gsuckz/SAR_ADC_IHP/out/consumos_conversion.txt

i_rms = 8.028214e-03
potencia_rms = 1.445079e-02
energia_conv = 2.032335e-10
energia_bit = 1.693613e-11
