gsuckz/SAR_ADC_IHP/tex/svg-inkscape/DT_comparator_tb_svg-raw.pdf

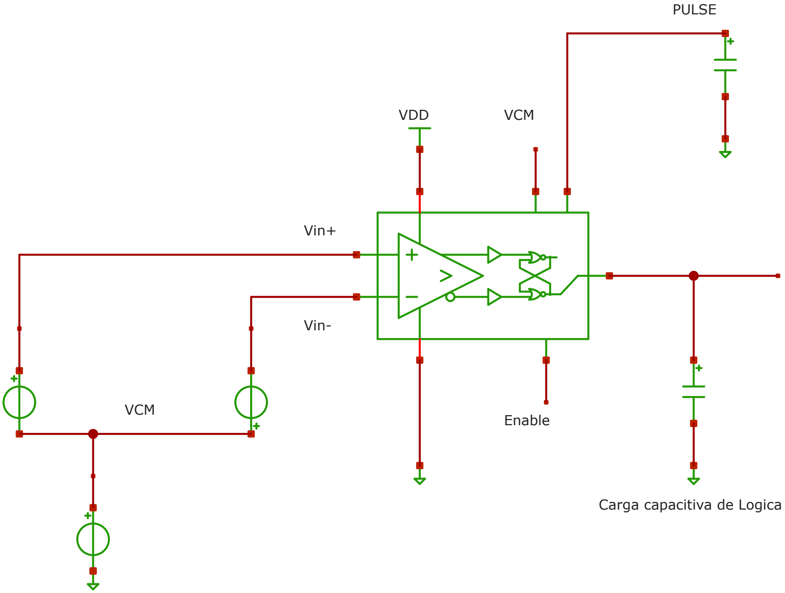
[picture p53: figure]
Carga capacitiva de Logica; VDD; Vin+; Vin-; PULSE; VCM; Enable
