gsuckz/SAR_ADC_IHP/tex/svg-inkscape/nol_diagrama_svg-raw.pdf

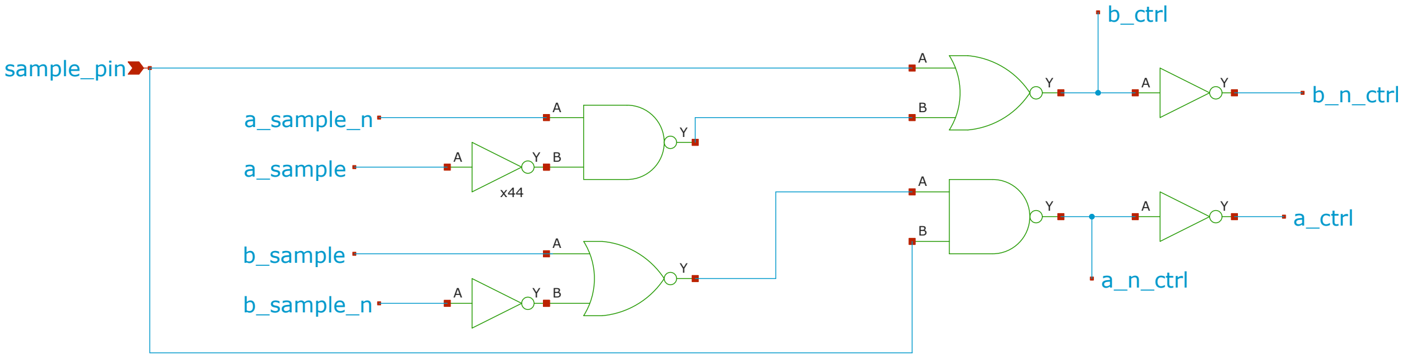
[picture p54: figure]
sample_pin; b_n_ctrl; b_ctrl; a_ctrl; a_n_ctrl; a_sample_n; a_sample; b_sample_n; b_sample
