gsuckz/SAR_ADC_IHP/tex/svg-inkscape/tb_sar_adc_svg-raw.pdf

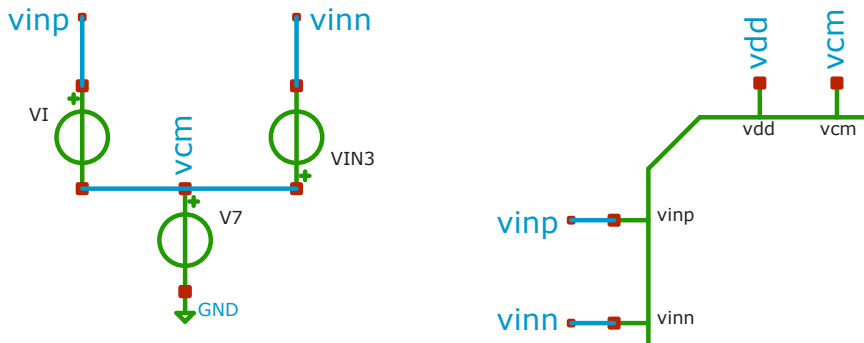
[picture p55: figure]
vinp; vinn; vdd; vcm VI; GND; VIN3; vcm

d0

vdd

# d1d2d3d4d5d6d7d8d9d10 d11

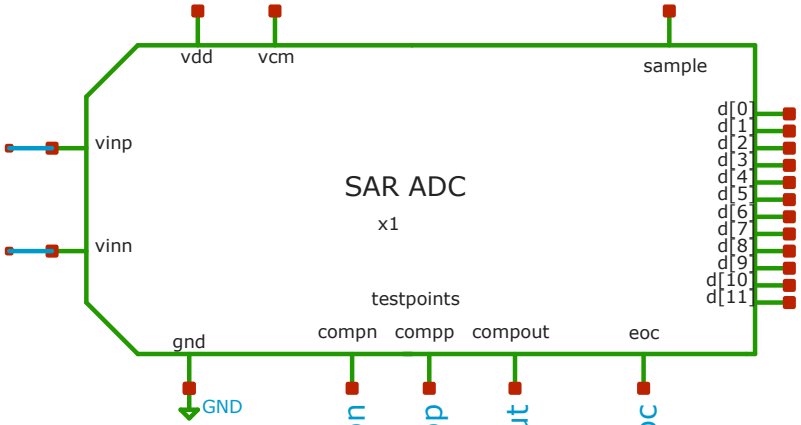
[picture p56: figure]
SAR ADC; sample; gnd; compn compp compout; testpoints; eoc; GND

## compn

## compp

## compout

eoc

GND

V2

## sample

GND

## sample

V3
