gsuckz/SAR_ADC_IHP/html/img/comparadorFullLayoutt.pdf

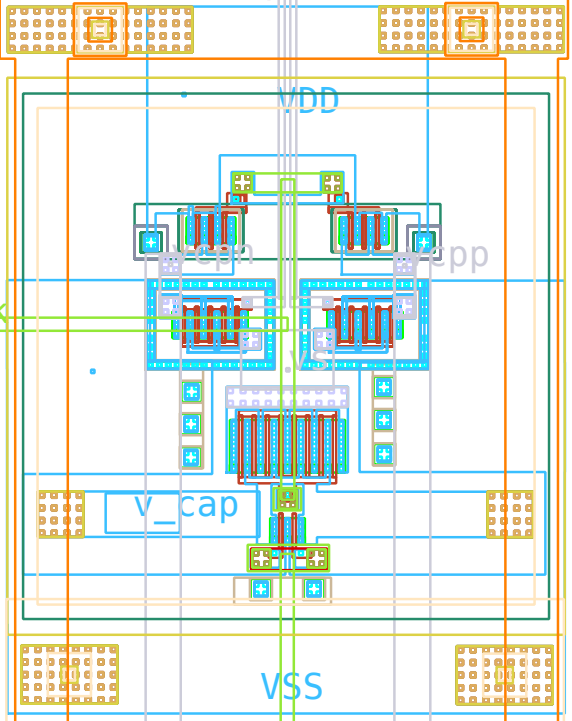
[picture p57: figure]
VSS; v_cap; VDD; vcpn; vcpp

sub! | sub!sub! | sub!
vinp | vinn
voutp | voutn

di_clk_n

di_clk
