gsuckz/SAR_ADC_IHP/tex/svg-inkscape/dynamic_biasing_comparator_export_svg-raw.pdf

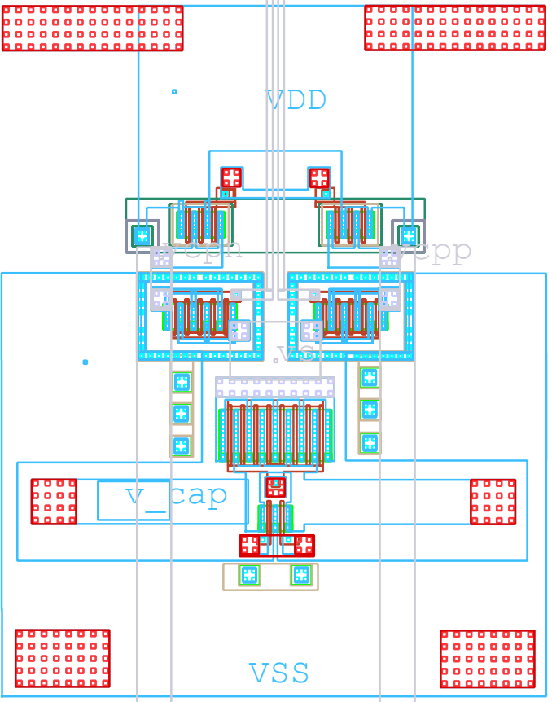
[picture p58: figure]
VSS; v_cap; VDD; vcpn; vcpp

sub! | sub!sub! | sub!

vinp vinn

voutp | voutn
