gsuckz/SAR_ADC_IHP/tex/svg-inkscape/lo_comp_preamp_scap_svg-raw.pdf

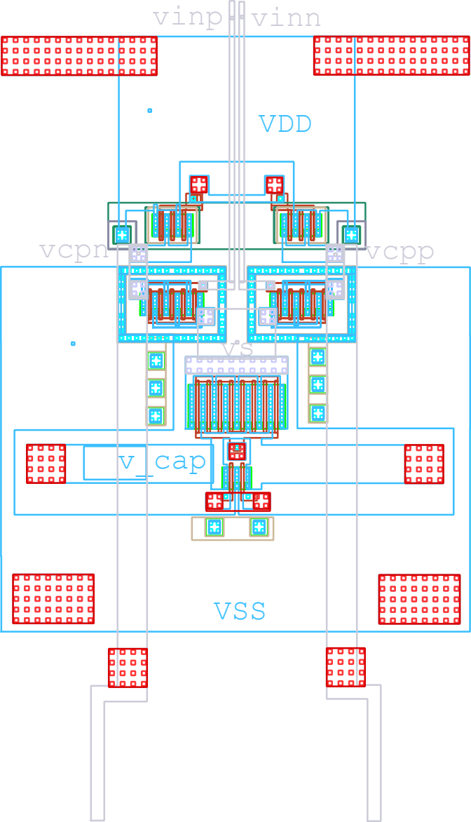
[picture p59: figure]
VSS; v_cap; VDD; vinp vinn; vcpn; vcpp
