gsuckz/SAR_ADC_IHP/tex/svg-inkscape/bit_cell_diagrama_svg-raw.pdf

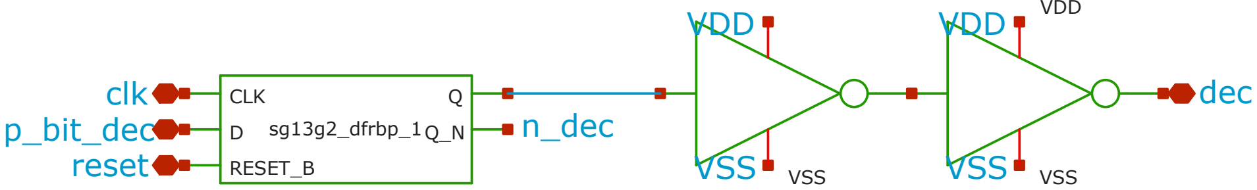
[picture p60: figure]
sg13g2_dfrbp_1; CLK; RESET_B; p_bit_dec; n_dec; clk; reset; dec; VSS; VDD
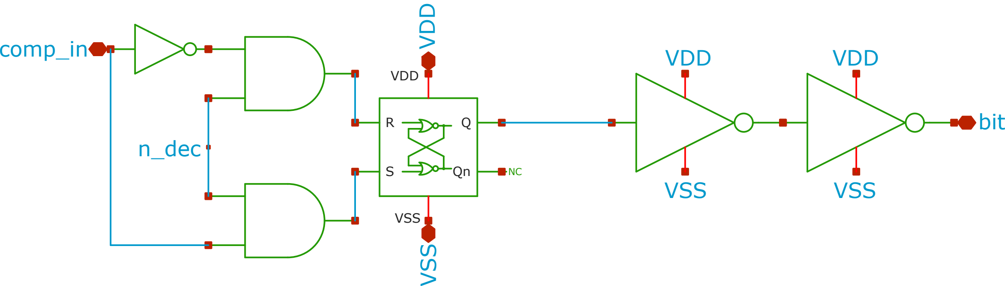
[picture p61: figure]
VDD; VSS; n_dec; comp_in; VDD VSS; bit
