gsuckz/SAR_ADC_IHP/tex/svg-inkscape/logica_parte_svg-raw.pdf

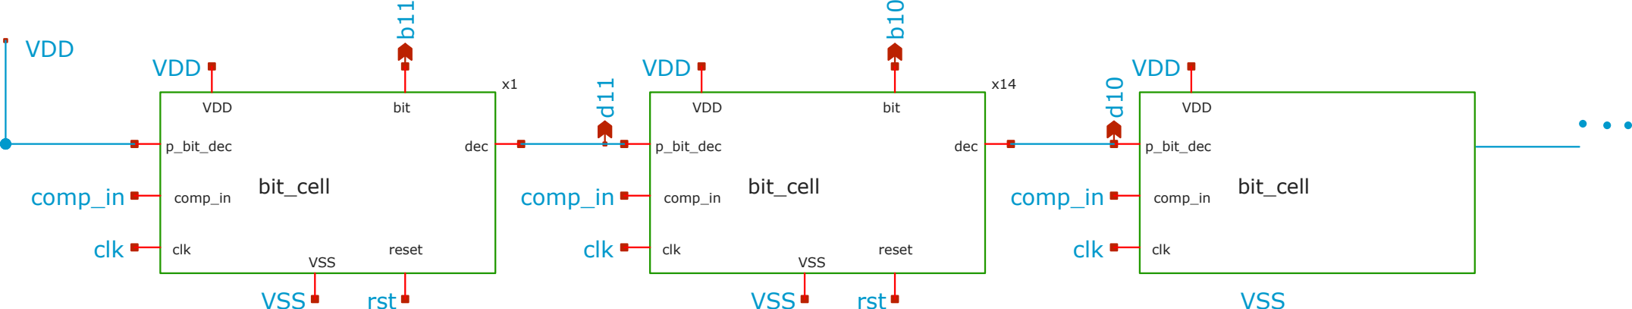
[picture p62: figure]
clk; rst; comp_in; VDD; bit_cell; p_bit_dec; reset; bit; VSS; dec
