gsuckz/SAR_ADC_IHP/tex/svg-inkscape/pgen_schimtt_trigger_diagrama_svg-raw.pdf

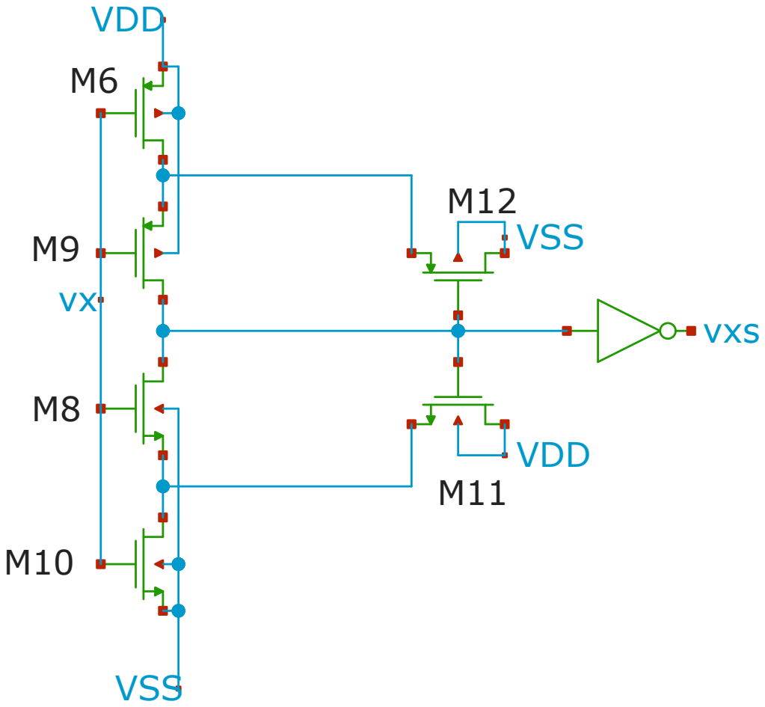
[picture p63: figure]
VDD; VSS; vxs
