gsuckz/SAR_ADC_IHP/tex/svg-inkscape/tg_diagrama_dummies_svg-raw.pdf

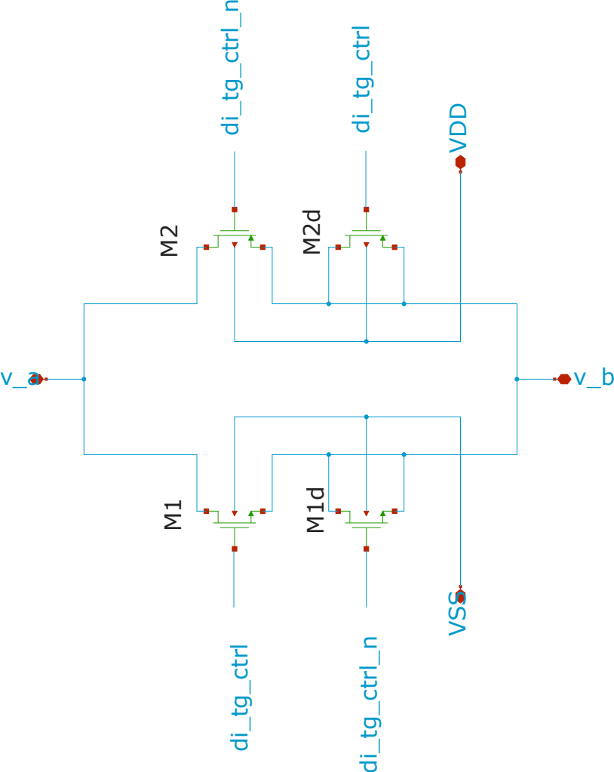
[picture p64: figure]
M²d M¹d; di_tg_ctrl di_tg_ctrl_n; VDD VSS di_tg_ctrl di_tg_ctrl_n
