gsuckz/SAR_ADC_IHP/html/assets/images/cdac/cdac_3x3_dark.png

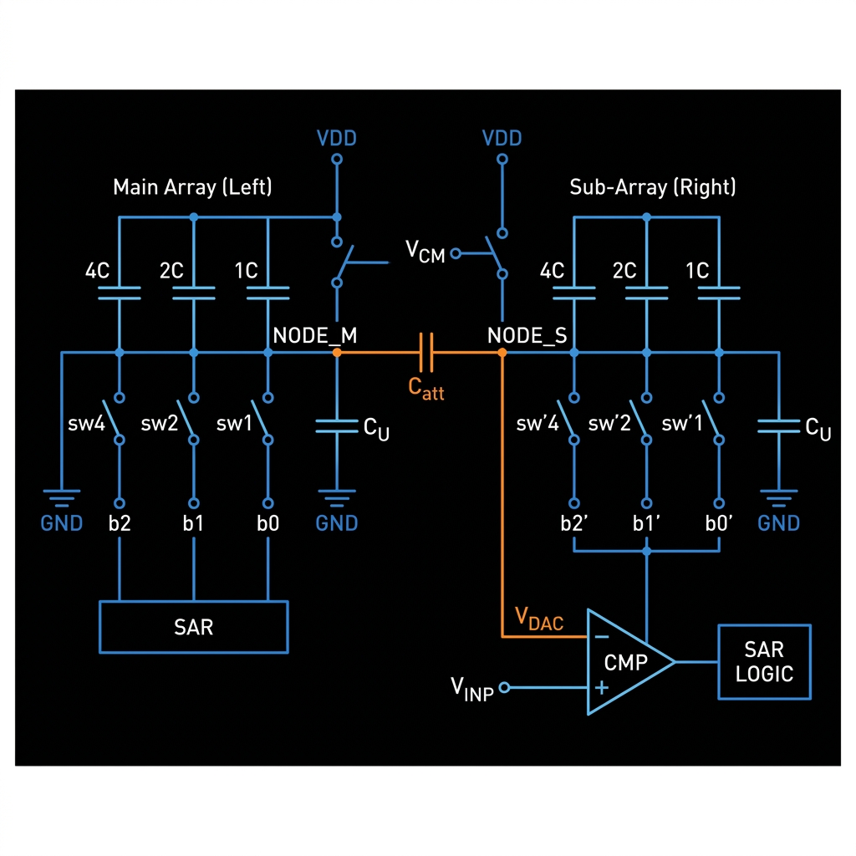
html/assets/images/cdac/cdac_3x3_dark.png
