gsuckz/SAR_ADC_IHP/html/assets/images/comparator/DT_comparator_dark.png

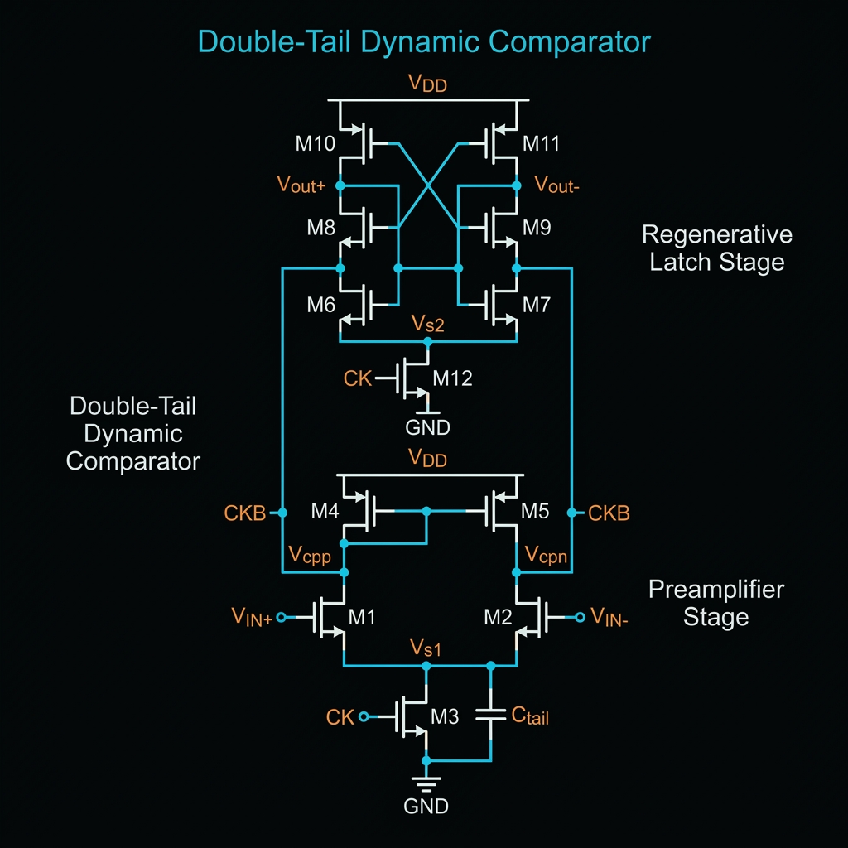
html/assets/images/comparator/DT_comparator_dark.png
