gsuckz/SAR_ADC_IHP/html/assets/images/logic_timing/pgen_diagram_dark.png

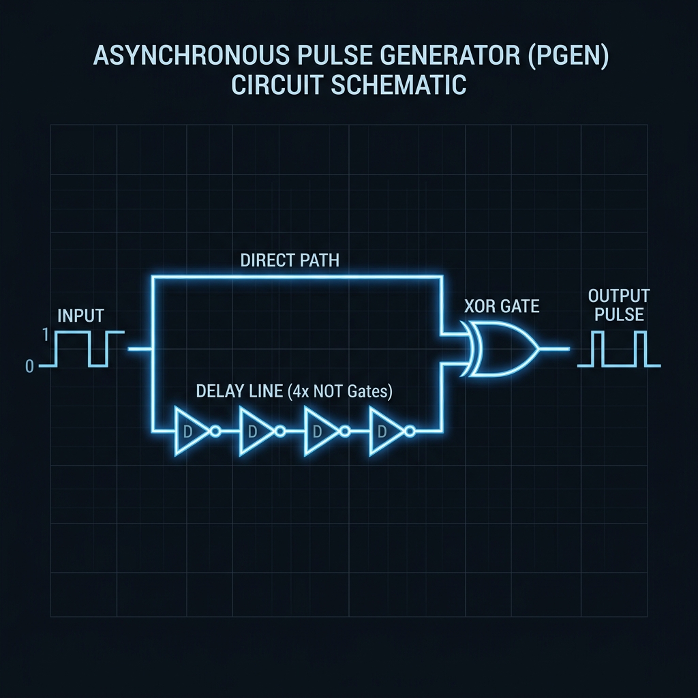
html/assets/images/logic_timing/pgen_diagram_dark.png
