gsuckz/SAR_ADC_IHP/html/assets/images/misc/logica_parte_dark.png

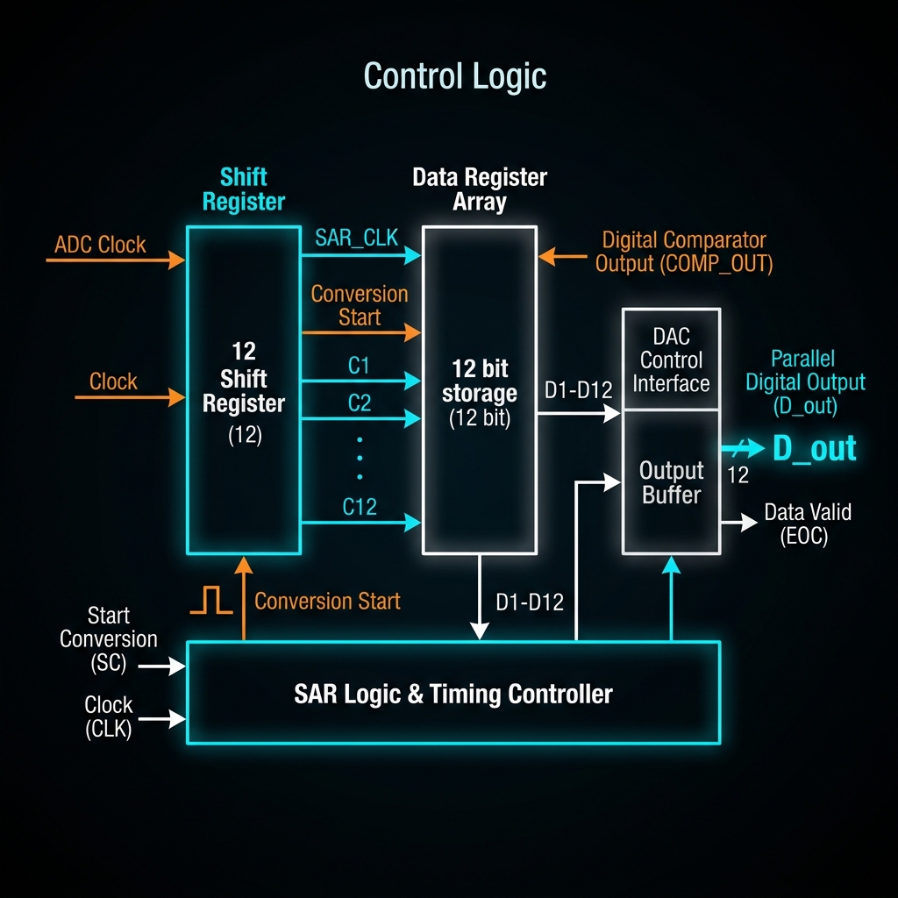
html/assets/images/misc/logica_parte_dark.png
