gsuckz/SAR_ADC_IHP/html/img2/cdac_cell_sch.png

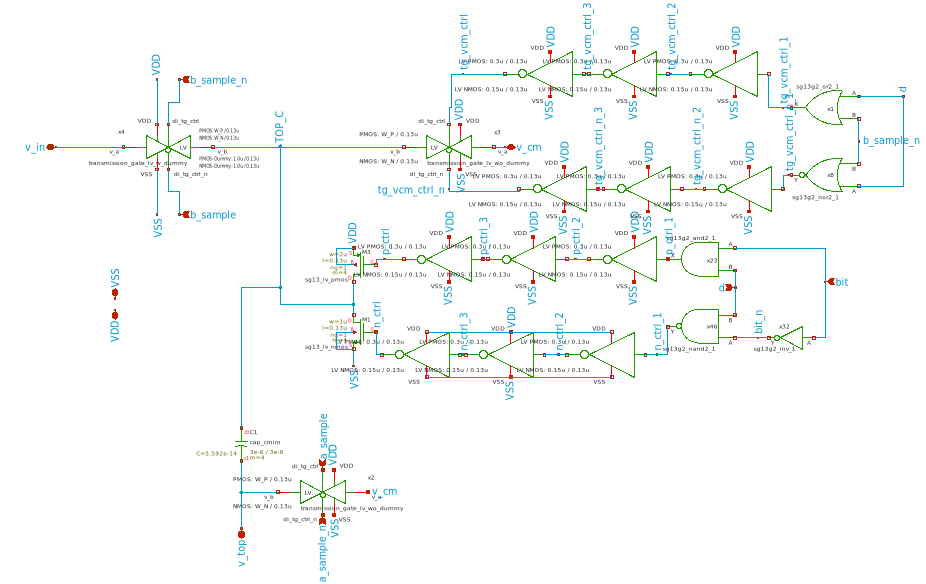
html/img2/cdac_cell_sch.png
