gsuckz/SAR_ADC_IHP/html/img2/Conversion IMCS ejemplo.png

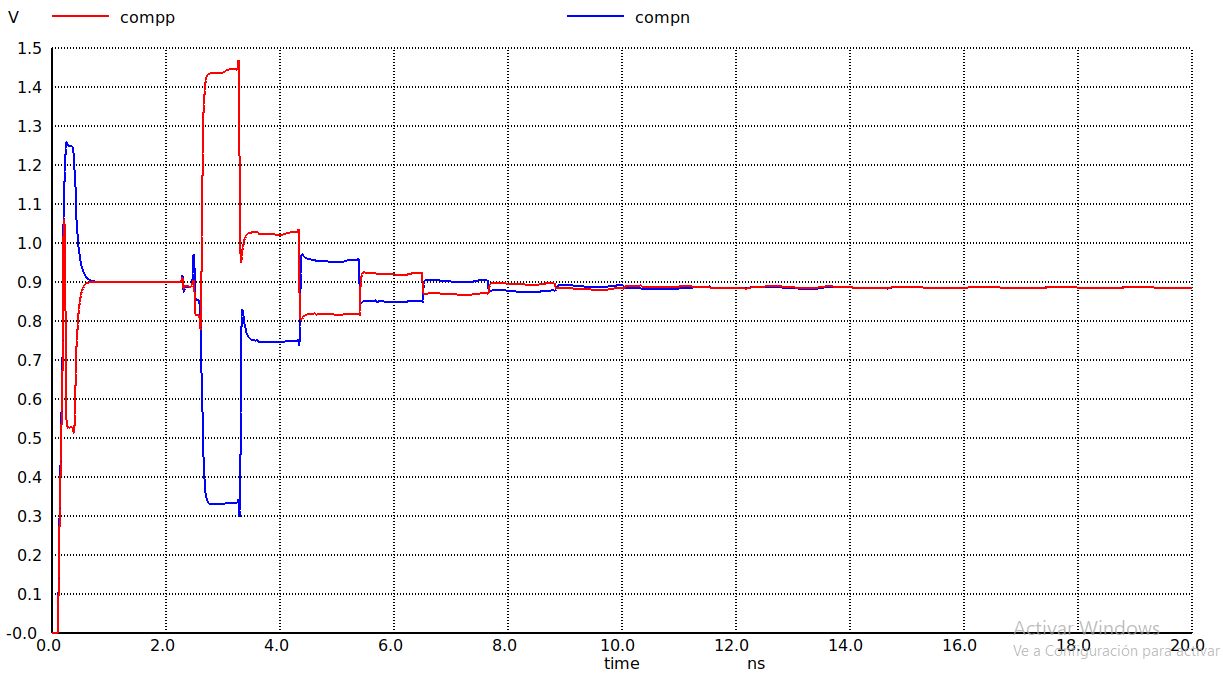
html/img2/Conversion IMCS ejemplo.png
