gsuckz/SAR_ADC_IHP/html/img2/explicacion_grounding_y_bridge_cap.png

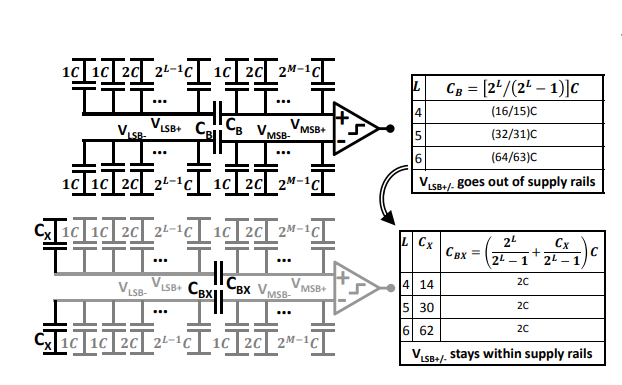
html/img2/explicacion_grounding_y_bridge_cap.png
