gsuckz/SAR_ADC_IHP/html/img2/formas_de_onda_logica_SAR.png

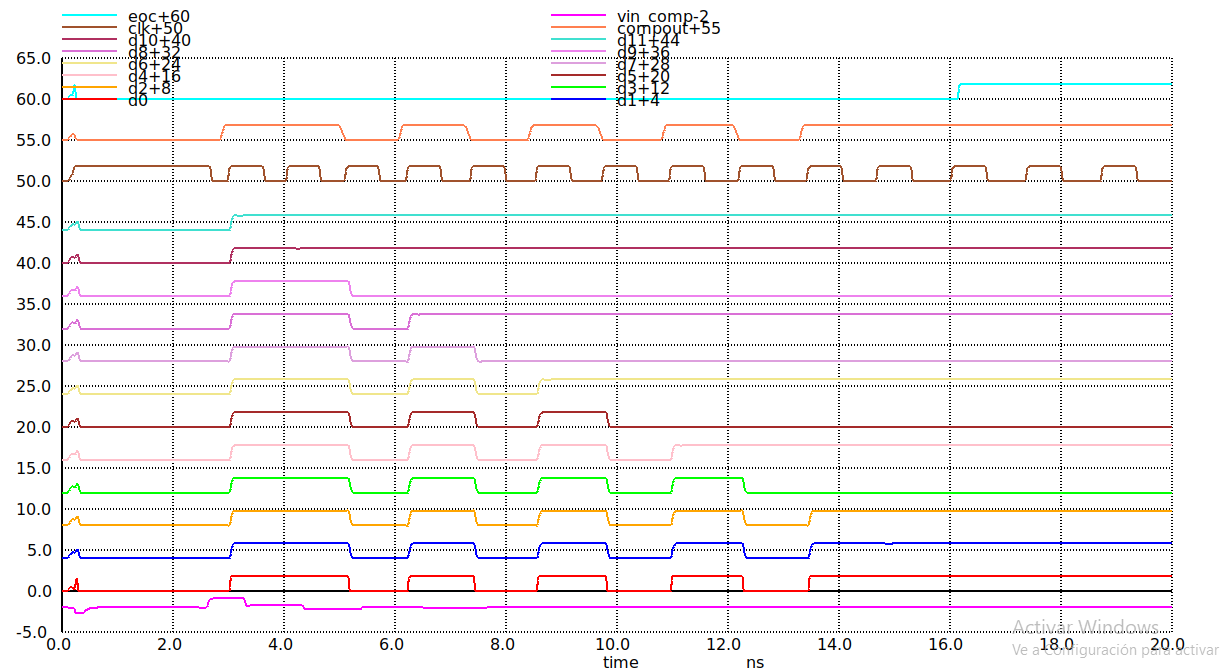
html/img2/formas_de_onda_logica_SAR.png
