gsuckz/SAR_ADC_IHP/html/img2/kickback_comparador_explicacion.png

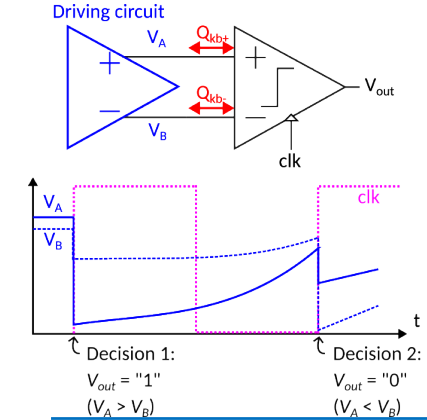
html/img2/kickback_comparador_explicacion.png
