gsuckz/SAR_ADC_IHP/html/img2/non_overlap_con_buffer_sch.png

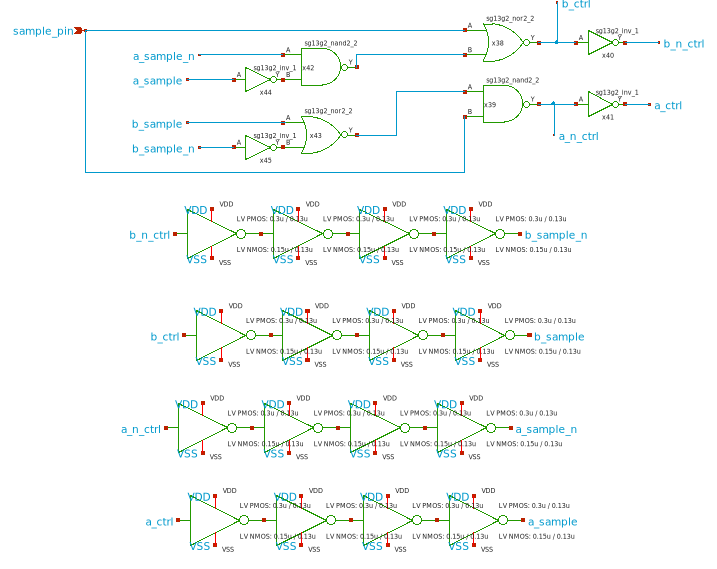
html/img2/non_overlap_con_buffer_sch.png
