gsuckz/SAR_ADC_IHP/html/img/CapturaDeUnaVentanaDeKlayout.png

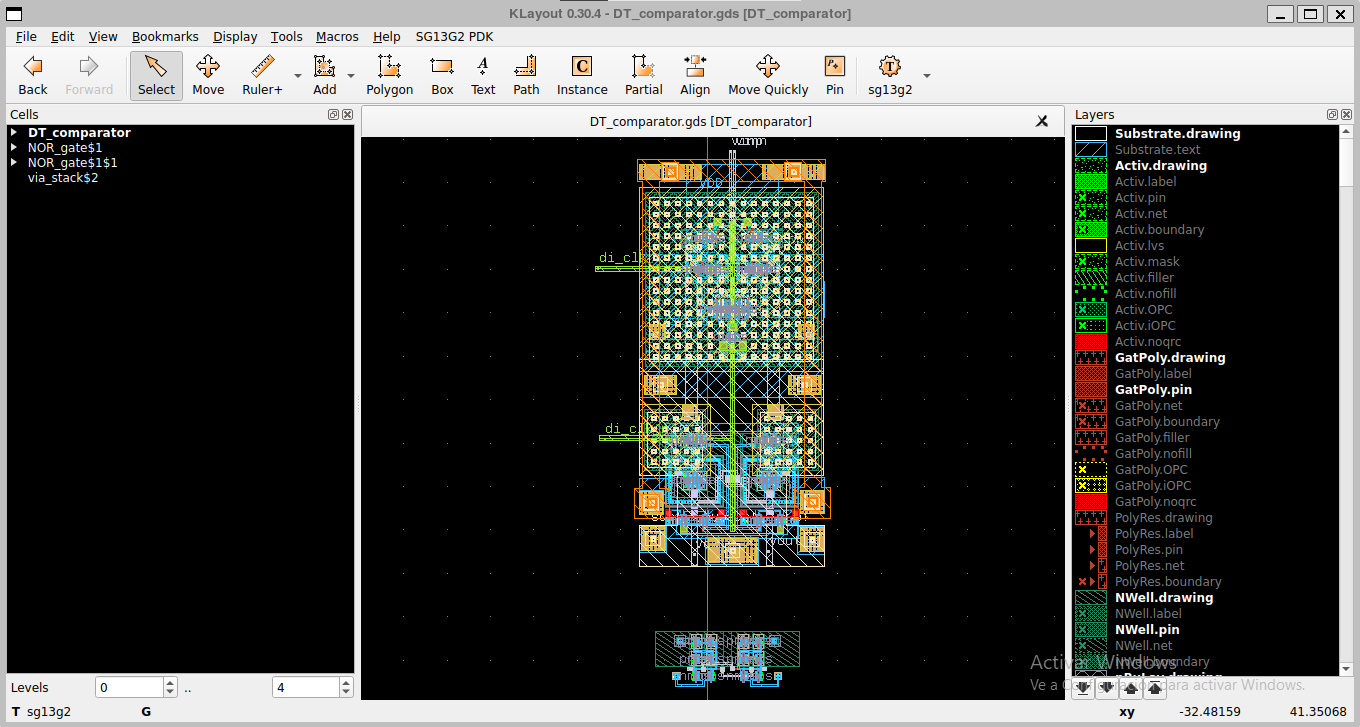
html/img/CapturaDeUnaVentanaDeKlayout.png
