gsuckz/SAR_ADC_IHP/html/img/CapturaDeUnaVentanaDeNgspice.png

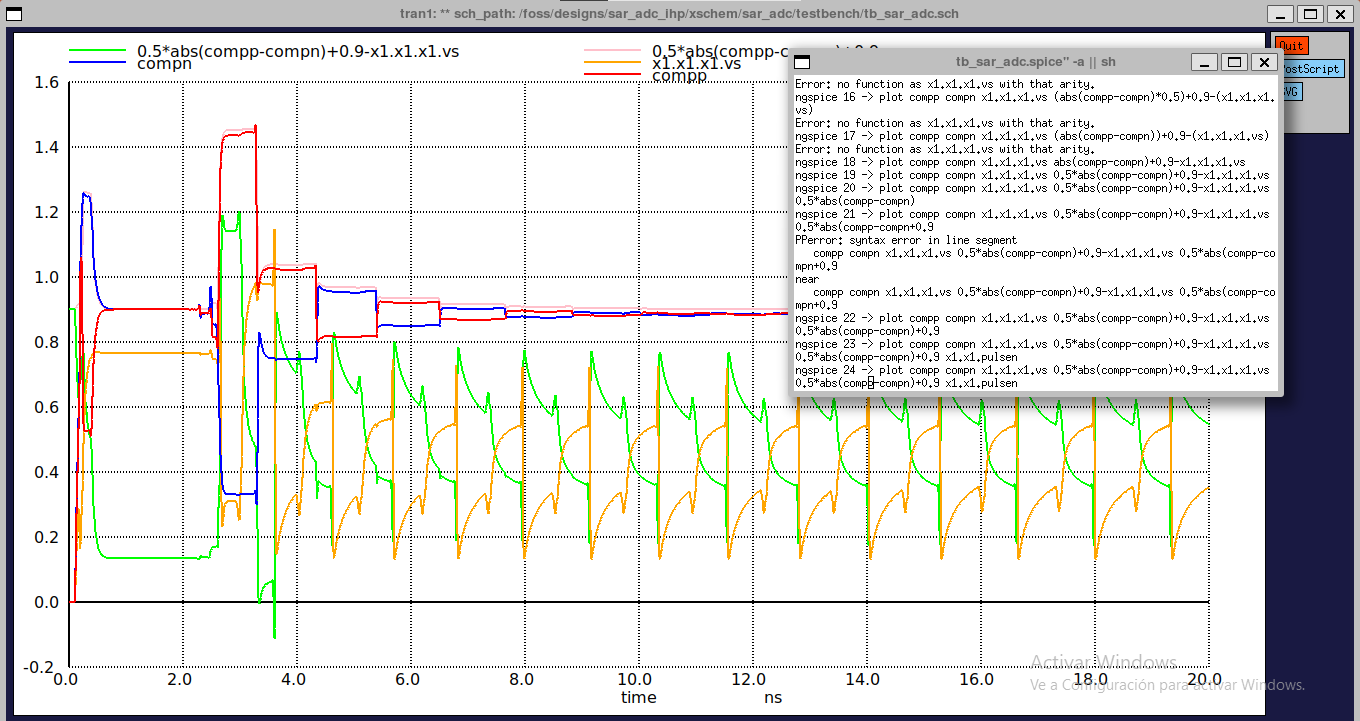
html/img/CapturaDeUnaVentanaDeNgspice.png
