gsuckz/SAR_ADC_IHP/html/img/CapturaDeUnaVentanaDeXschem.png

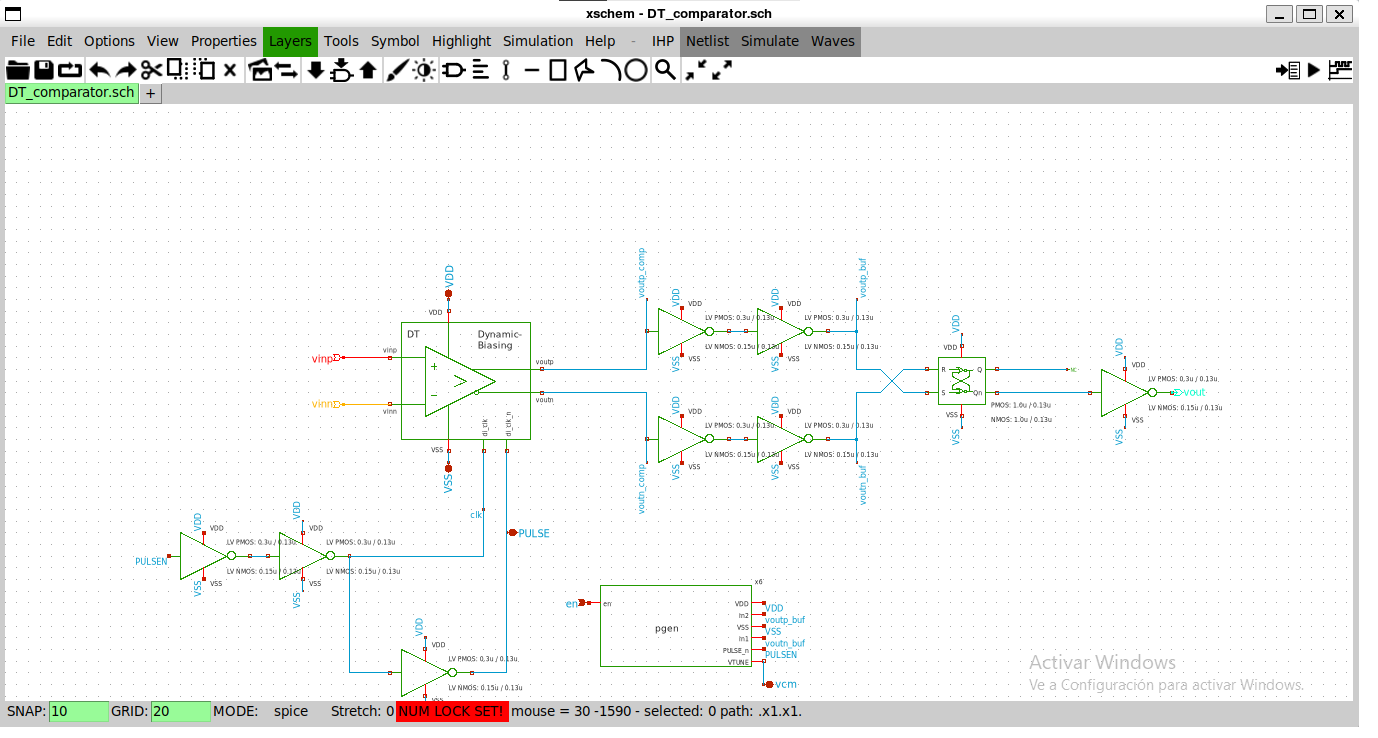
html/img/CapturaDeUnaVentanaDeXschem.png
