gsuckz/SAR_ADC_IHP/html/img/DiagramaPulseGenExplicado.png

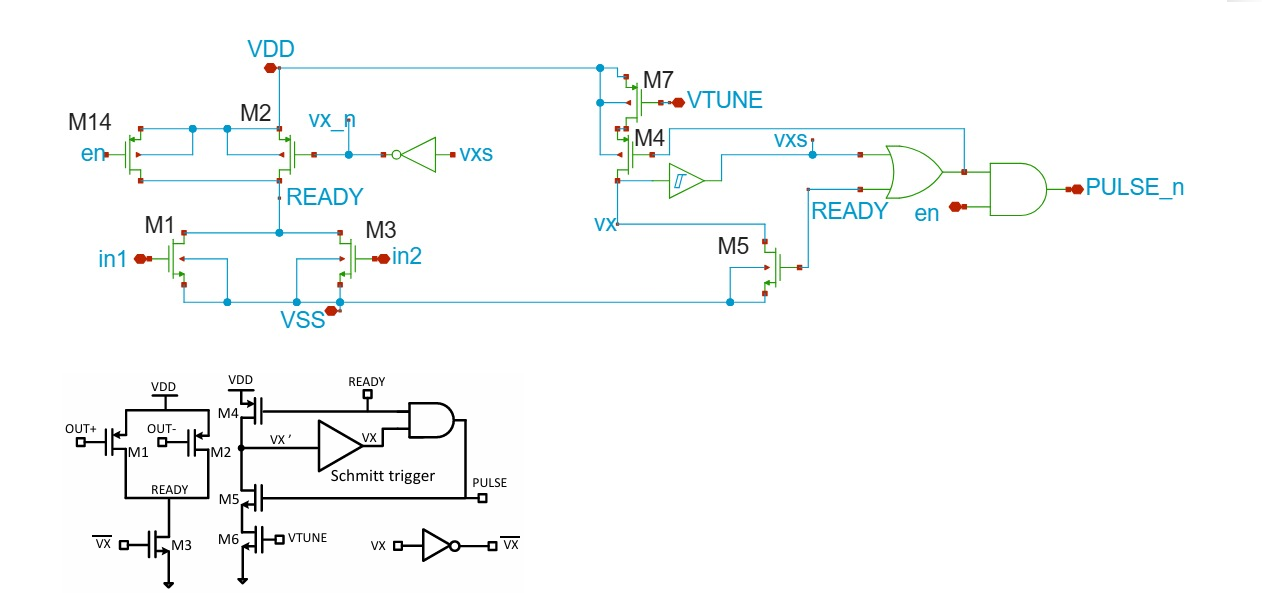
html/img/DiagramaPulseGenExplicado.png
