gsuckz/SAR_ADC_IHP/html/img/ExplicacionFasesDelComparadorCompletoEnDiagrama.png

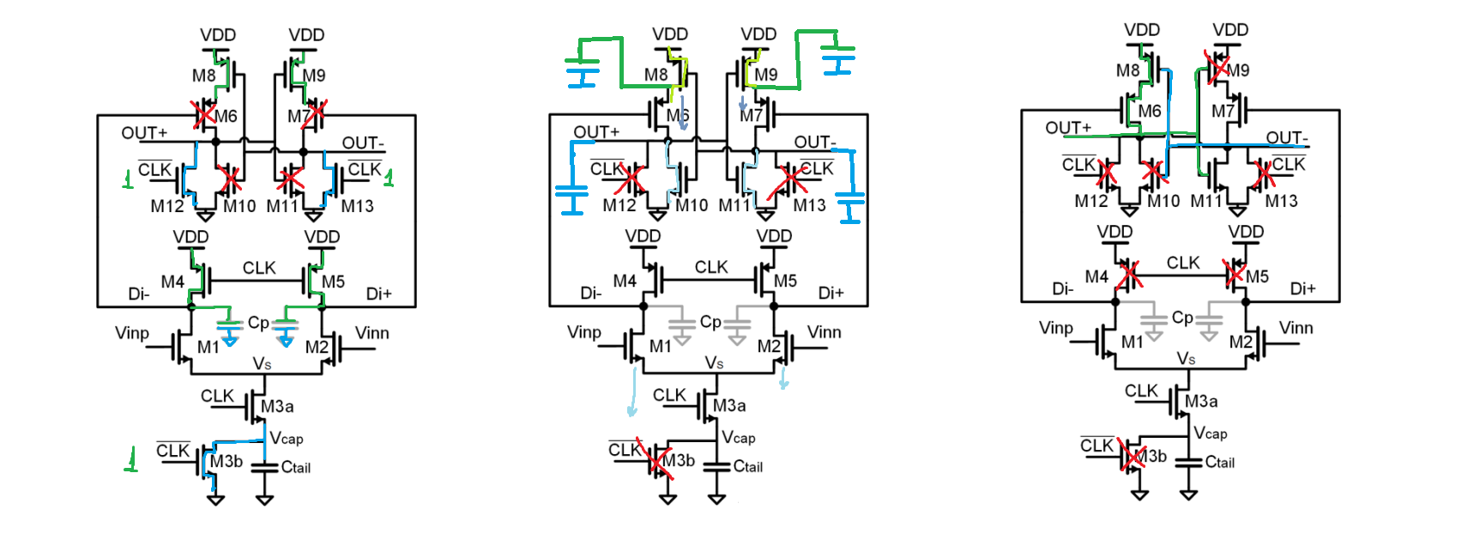
html/img/ExplicacionFasesDelComparadorCompletoEnDiagrama.png
