gsuckz/SAR_ADC_IHP/html/img/IMCS_Explicacion.png

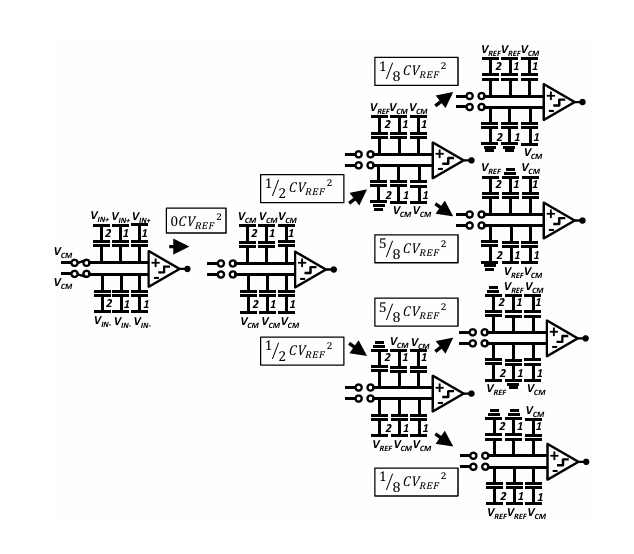
html/img/IMCS_Explicacion.png
