gsuckz/SAR_ADC_IHP/html/img/InstanciacionDeUnaPCellEnKLayout.png

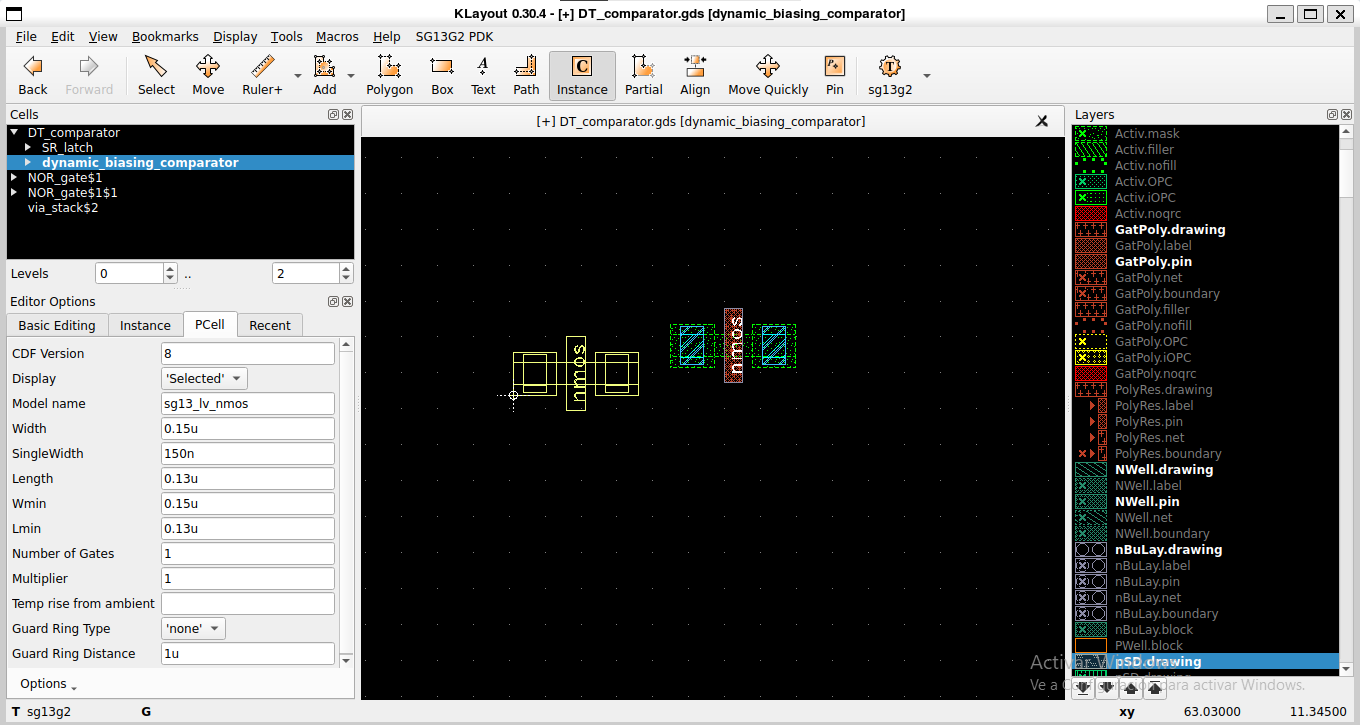
html/img/InstanciacionDeUnaPCellEnKLayout.png
