gsuckz/SAR_ADC_IHP/html/img/SeñalesComapradorVin219mV.png

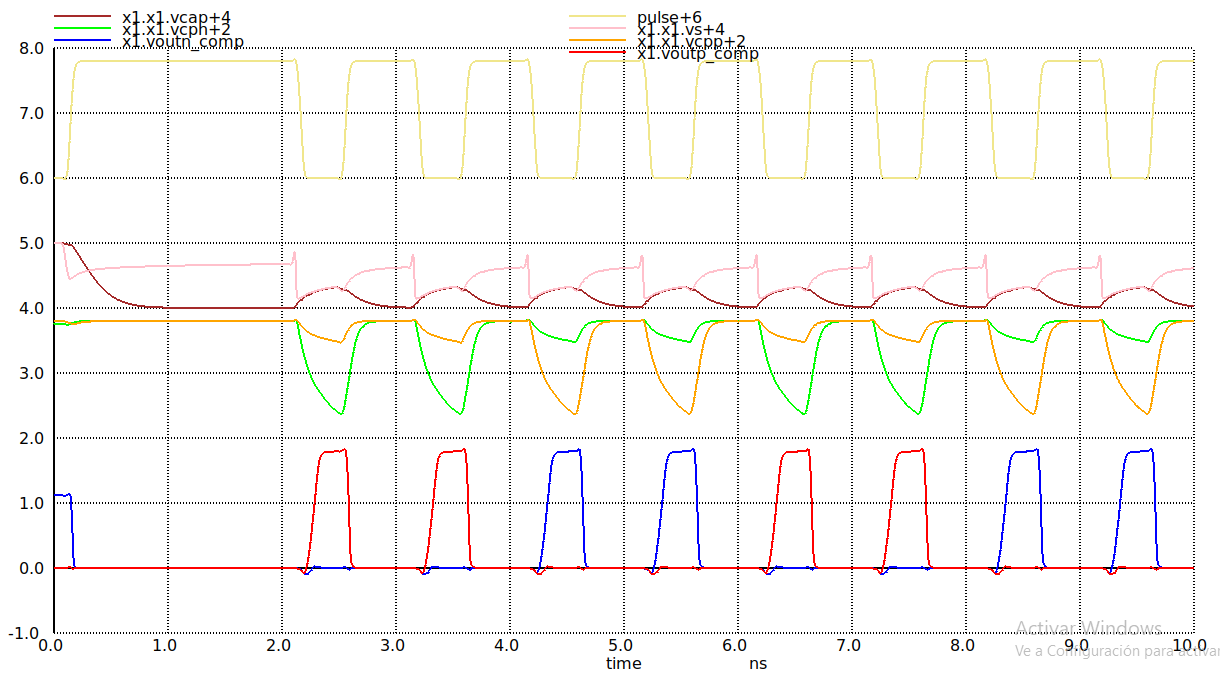
html/img/SeñalesComapradorVin219mV.png
