gsuckz/SAR_ADC_IHP/html/img/SeñalesComapradorVin219uV.png

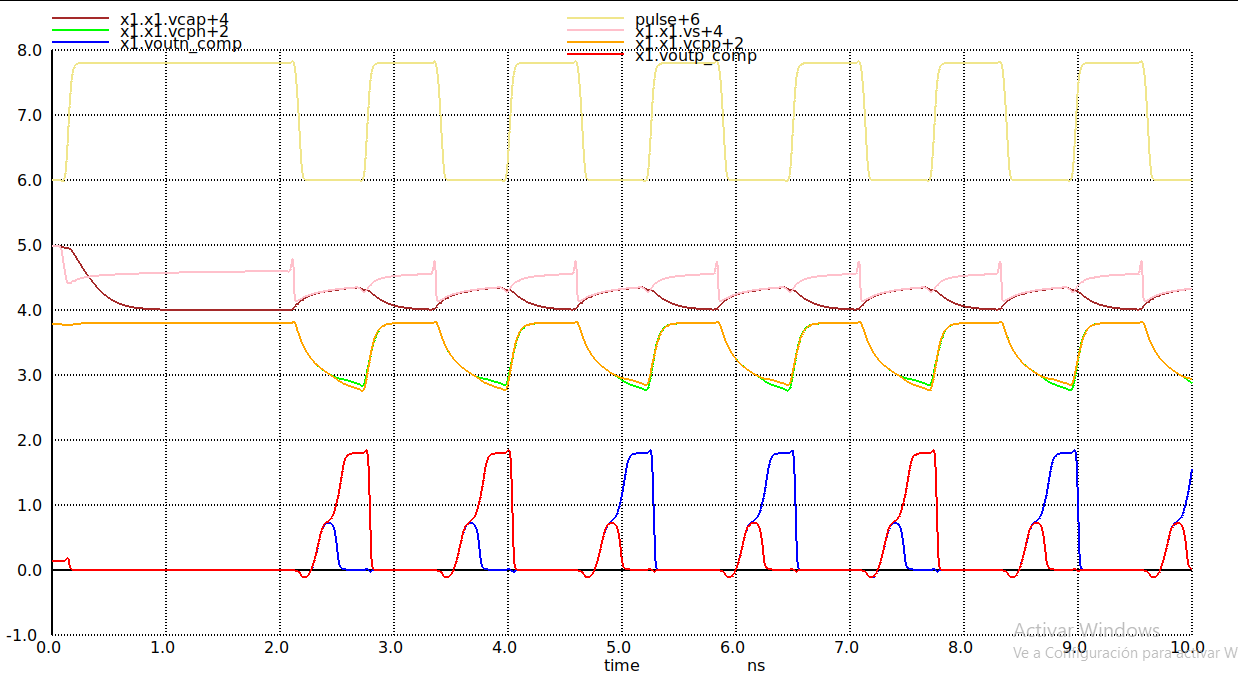
html/img/SeñalesComapradorVin219uV.png
