gsuckz/SAR_ADC_IHP/html/img/StackDelProcesoIHPsg13g2Layout.png

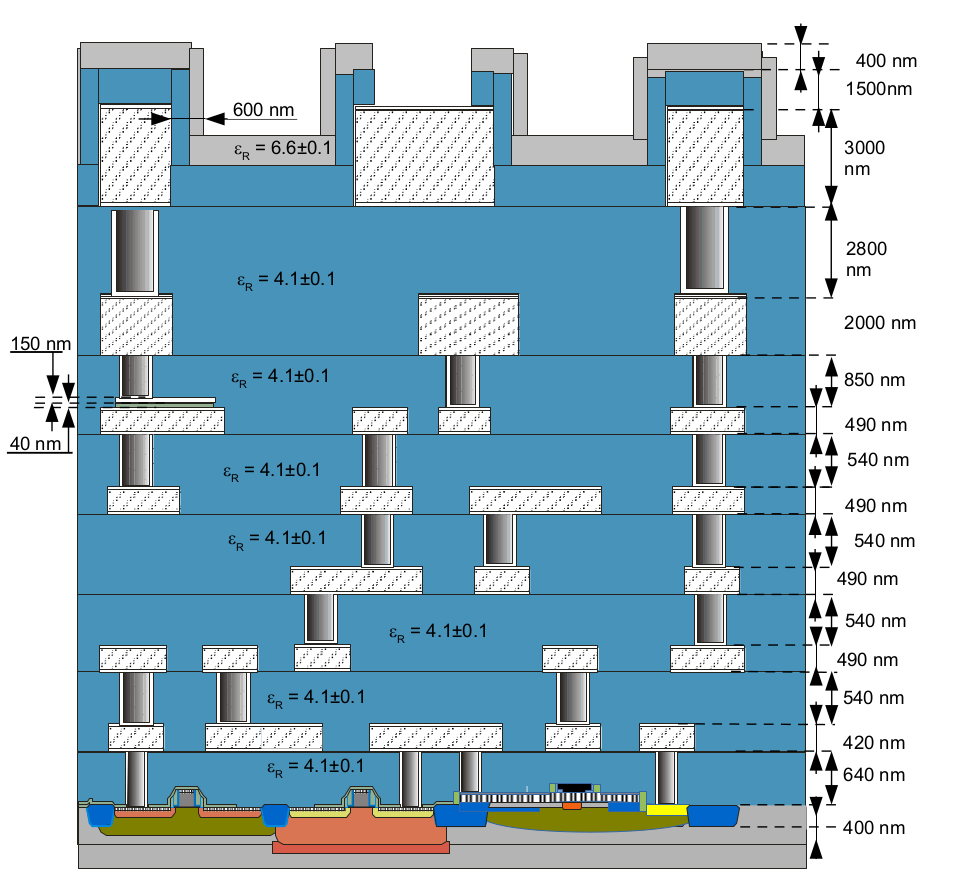
html/img/StackDelProcesoIHPsg13g2Layout.png
