gsuckz/SAR_ADC_IHP/html/img/Switch de muestreo con transistores dummy.png

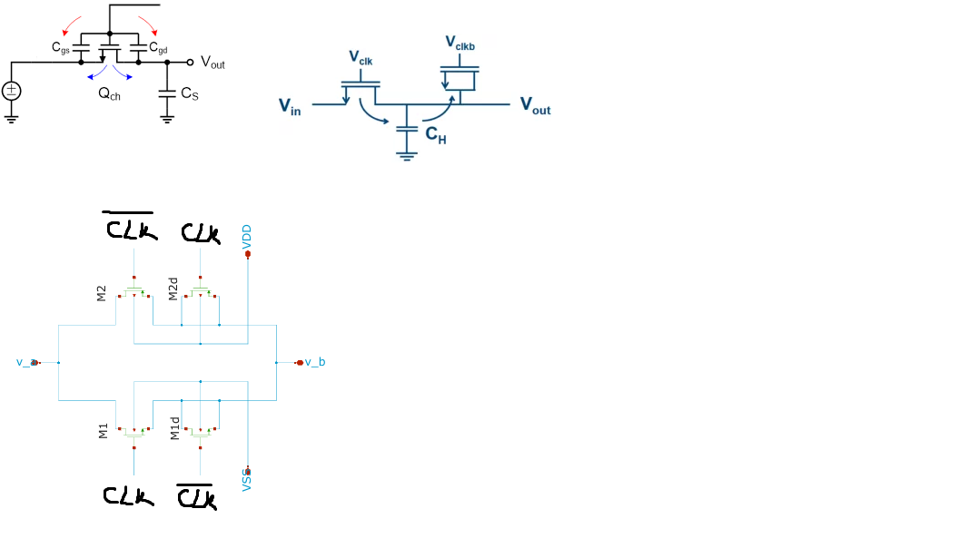
html/img/Switch de muestreo con transistores dummy.png
