gsuckz/SAR_ADC_IHP/xschem/sar.png

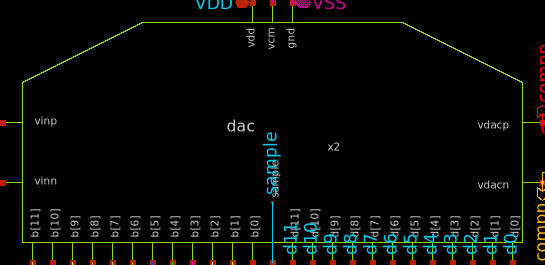
xschem/sar.png
