gsuckz/SAR_ADC_IHP/tex/svg-inkscape/tb_top_tran_step_svg-raw.pdf

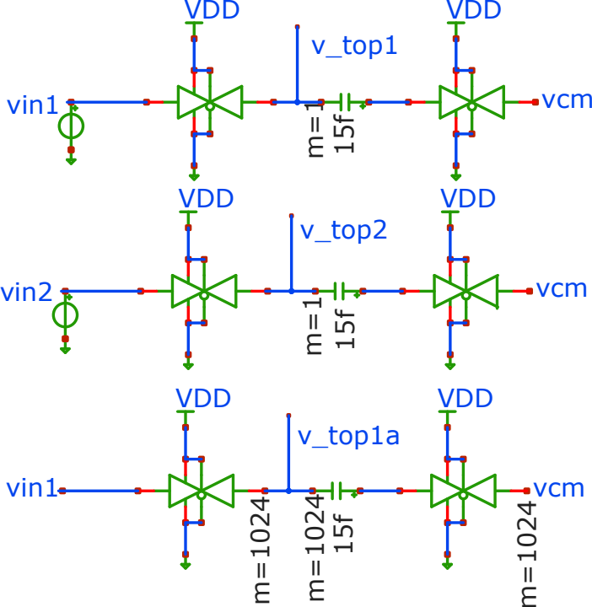
[picture p88: figure]
vin1; VDD; vcm; v_top1; vin2; v_top2; v_top1a m=¹ 15f m=¹ 15f 15f
