gsuckz/SAR_ADC_IHP/tex/svg-inkscape/dynamic_biasing_comparator_svg-raw.pdf

## B VDD

# Latch

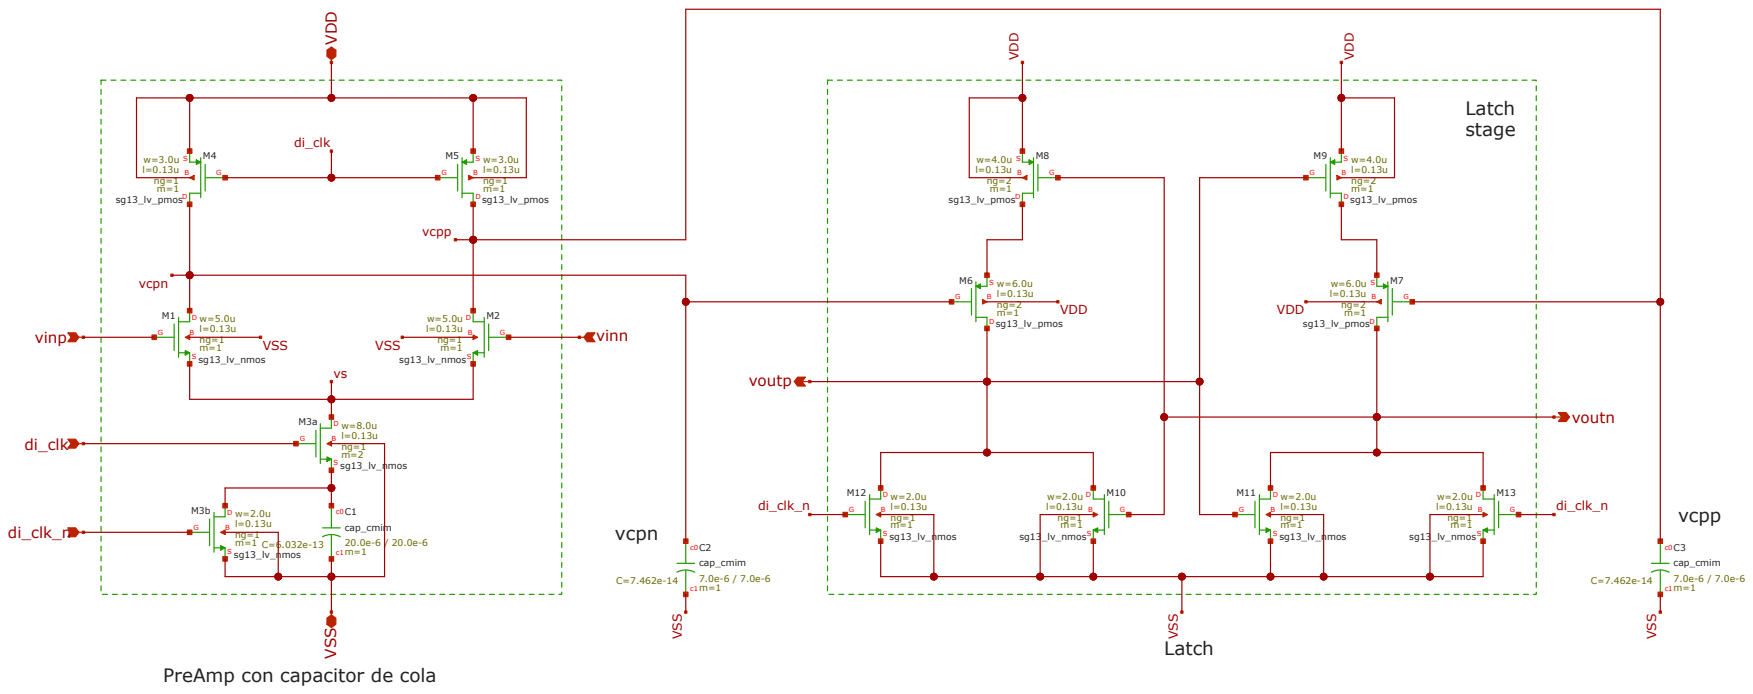
[picture p89: page 1]
VDD; voutp; voutn; di_clk_n; VSS; vinp; vinn; di_clk; sg13_lv_nmos; sg13_lv_pmos; vcpp; vcpn; cap_cmim; stage; Latch

PreAmp con capacitor de cola
