gsuckz/SAR_ADC_IHP/tex/svg-inkscape/conversion_ejemplo_1_svg-raw.pdf

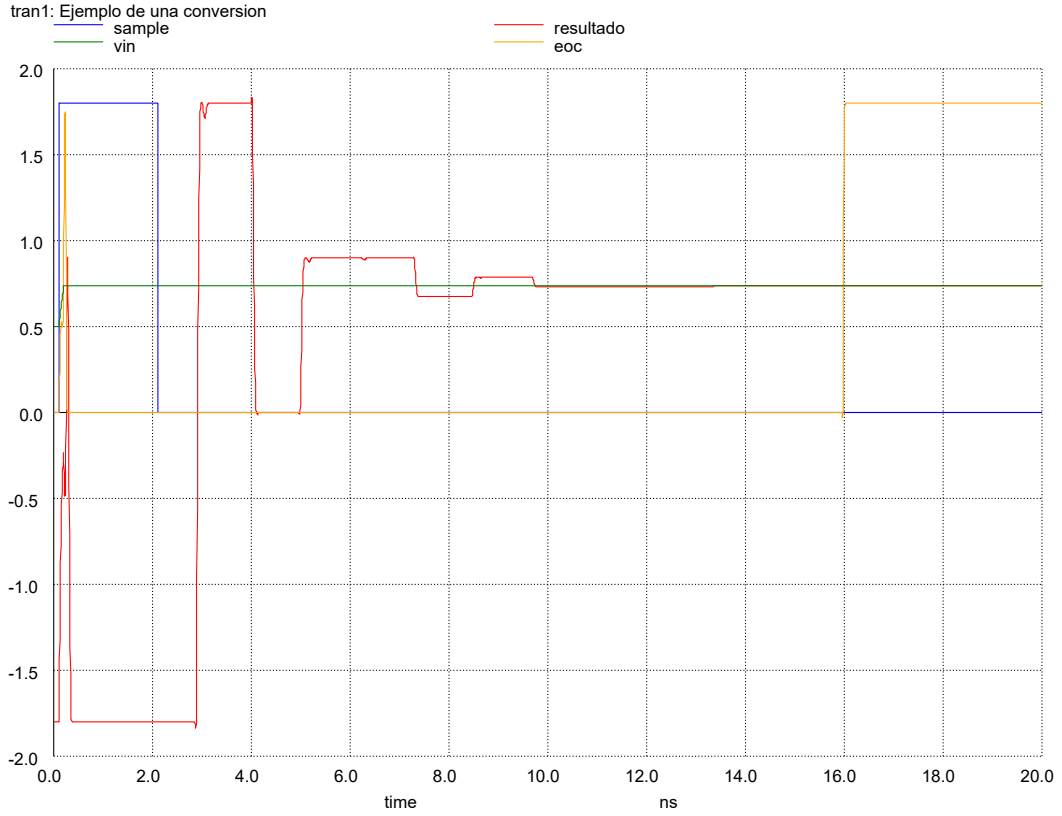
[picture p90: page 1]
time; sample; resultado; vin; eoc

tran1: Ejemplo de una conversion
