gsuckz/SAR_ADC_IHP/tex/svg-inkscape/nol_formas_de_onda_editado_svg-raw.pdf

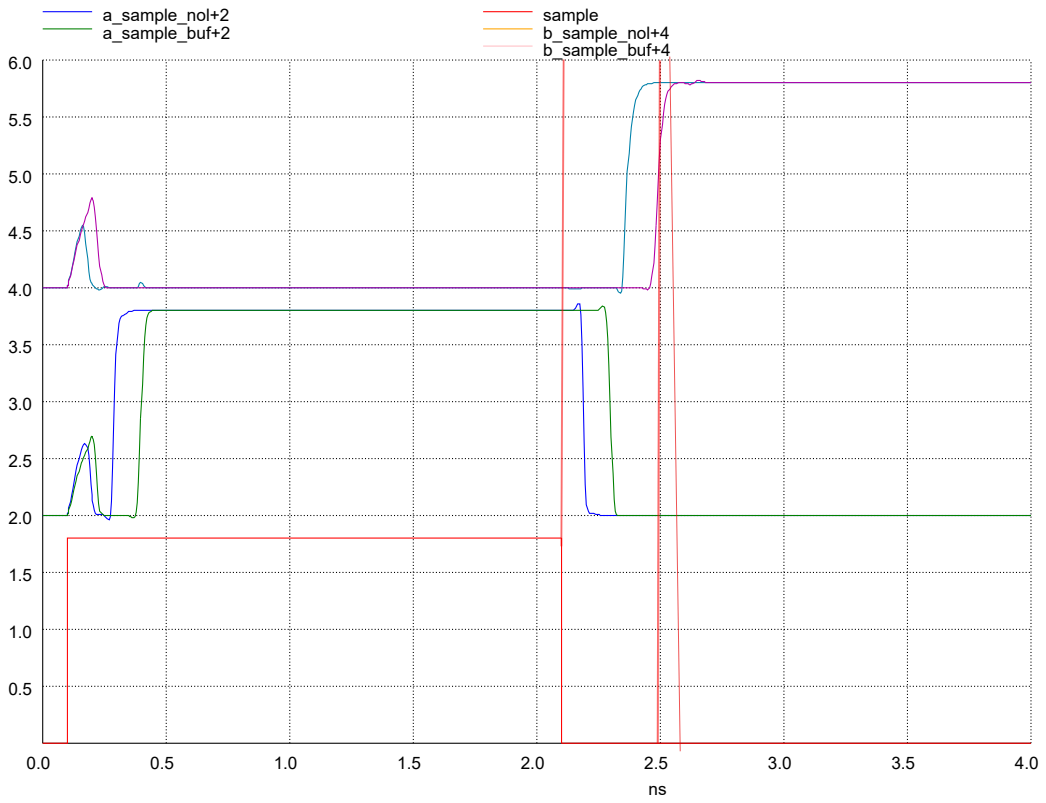
[picture p91: page 1]
a_sample_nol+2; sample; a_sample_buf+2; b_sample_nol+4; b_sample_buf+4
