gsuckz/SAR_ADC_IHP/tex/svg-inkscape/nol_salidas_editado_svg-raw.pdf

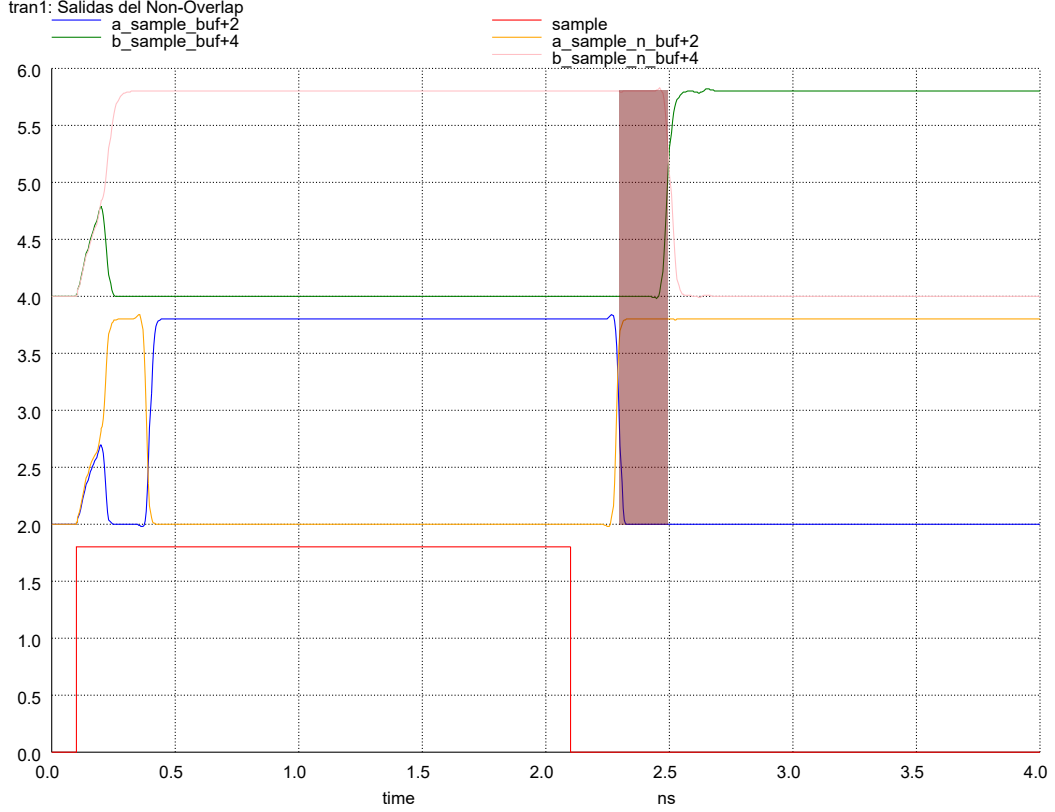
[picture p92: page 1]
time; a_sample_buf+2; sample; b_sample_buf+4; a_sample_n_buf+2; b_sample_n_buf+4

tran1: Salidas del Non-Overlap
