gsuckz/SAR_ADC_IHP/tex/svg-inkscape/respuesta_c_svg-raw.pdf

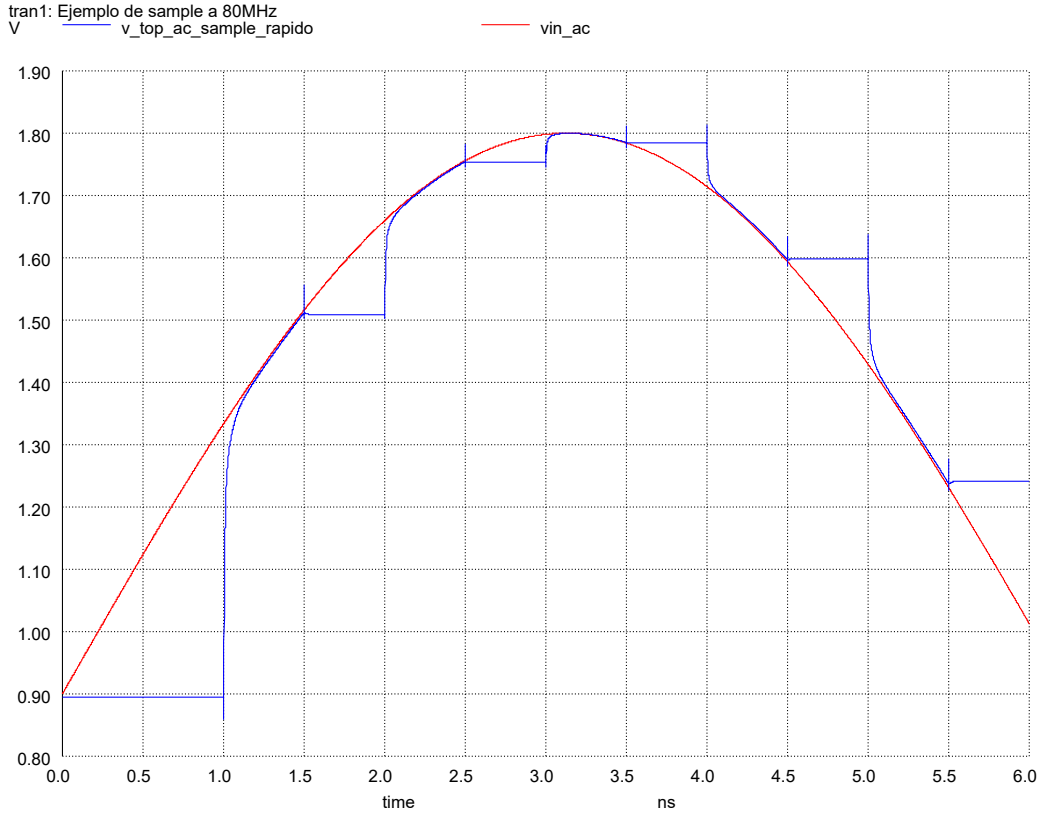
[picture p93: page 1]
time; v_top_ac_sample_rapido; vin_ac

tran1: Ejemplo de sample a 80MHz
