gsuckz/SAR_ADC_IHP/tex/svg-inkscape/rise_topa_svg-raw.pdf

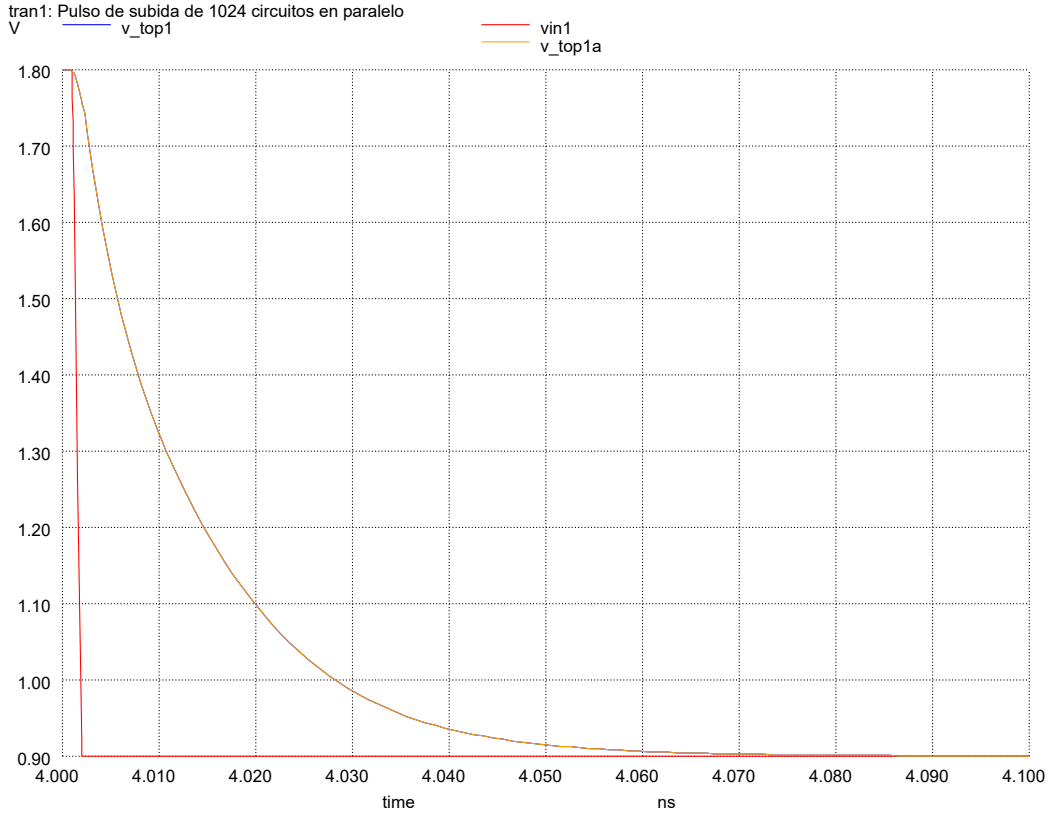
[picture p94: page 1]
time; v_top1; vin1; v_top1a

tran1: Pulso de subida de 1024 circuitos en paralelo
