gsuckz/SAR_ADC_IHP/html/img/pgenlayoutexplicado.pdf

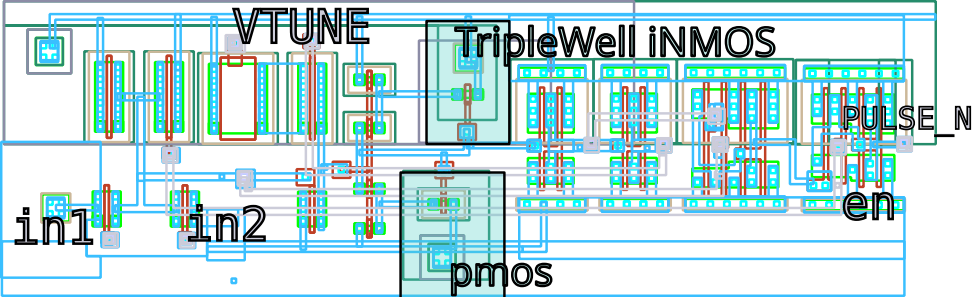
[picture p95: page 1]
VTUNE; PULSE_N; TripleWell iNMOS; pmos
