gsuckz/SAR_ADC_IHP/tex/svg-inkscape/lo_comp_preamp_fl_svg-raw.pdf

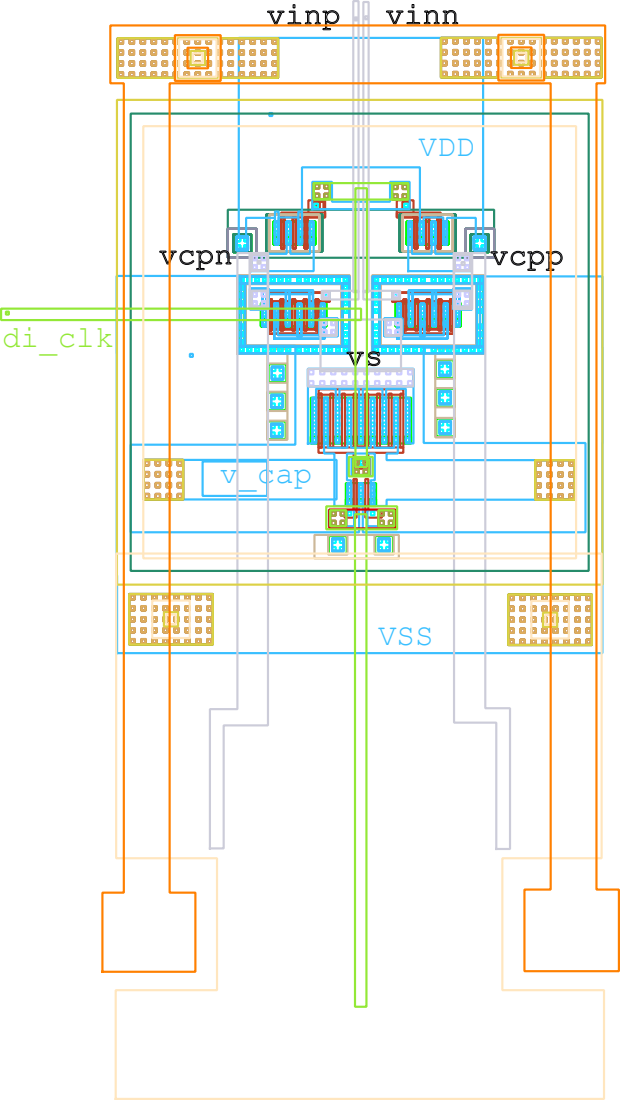
[picture p96: page 1]
VSS; v_cap; VDD; vinp; vinn; vcpn; vcpp; vs di_clk
