gsuckz/SAR_ADC_IHP/tex/svg-inkscape/bindra_preamp_diagrama_svg-raw.pdf

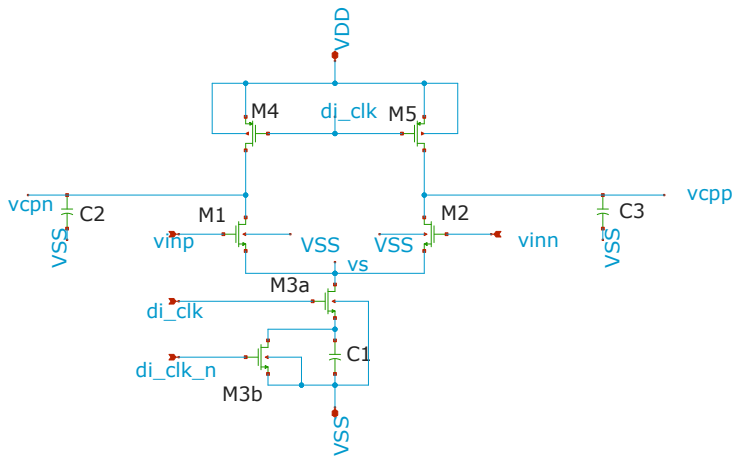
[picture p97: page 1]
VDD; di_clk_n; VSS; vinp; vinn; di_clk; di_clk M5; vcpp vcpn
