gsuckz/SAR_ADC_IHP/tex/svg-inkscape/conversion_comparador_1_svg-raw.pdf

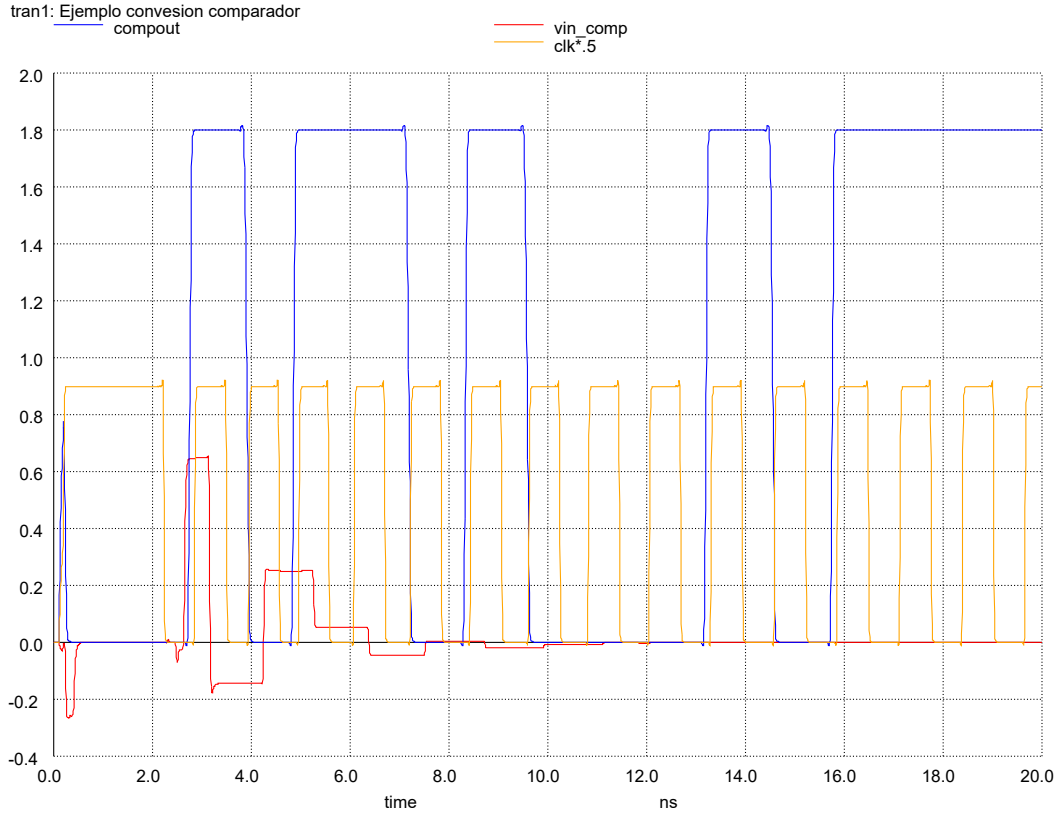
[picture p98: page 1]
time; compout; vin_comp; clk*.5

tran1: Ejemplo convesion comparador
