gsuckz/SAR_ADC_IHP/tex/svg-inkscape/dac_unit_cell_n_svg-raw.pdf

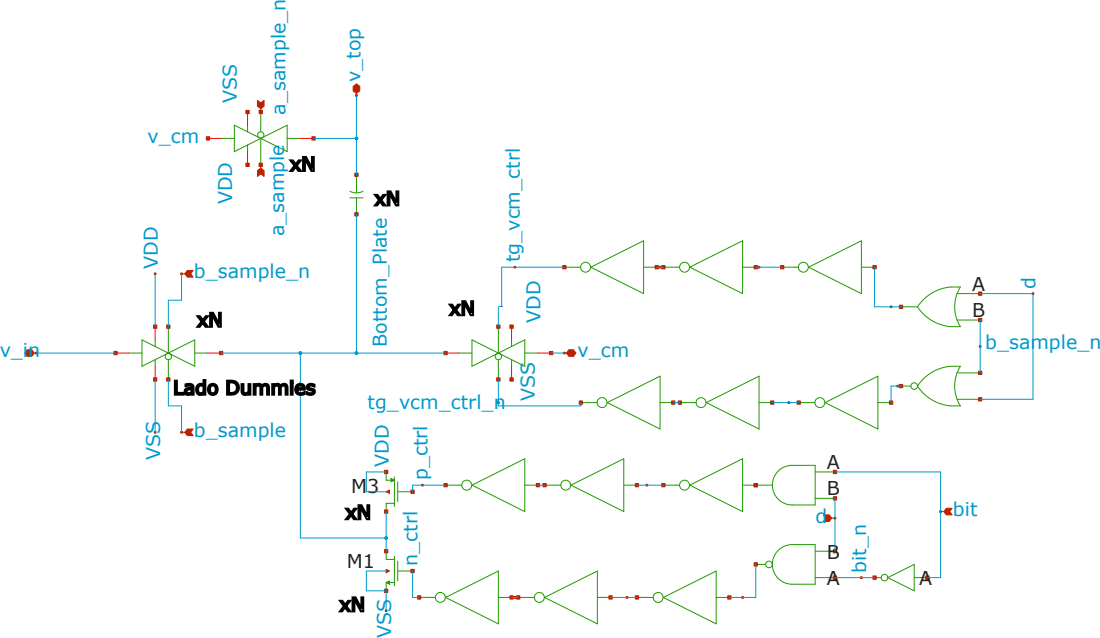
[picture p99: page 1]
v_top; a_sample a_sample_n; VDD VSS; b_sample; b_sample_n; VSS VDD; bit; ABAB; Bottom_Plate; tg_vcm_ctrl; tg_vcm_ctrl_n p_ctrl n_ctrl; bit_n
