gsuckz/SAR_ADC_IHP/tex/svg-inkscape/delays_sah_svg-raw.pdf

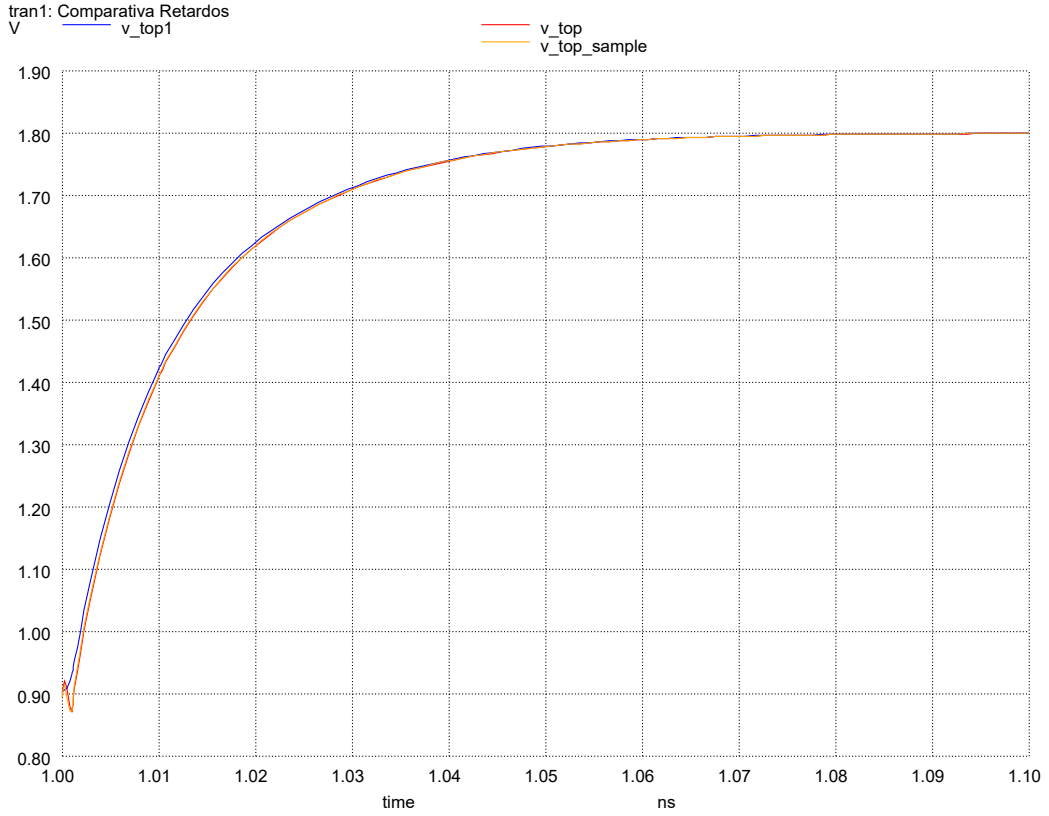
[picture p100: page 1]
time; tran1: Comparativa Retardos; v_top1; v_top; v_top_sample
