gsuckz/SAR_ADC_IHP/tex/svg-inkscape/fanout_opt_svg-raw.pdf

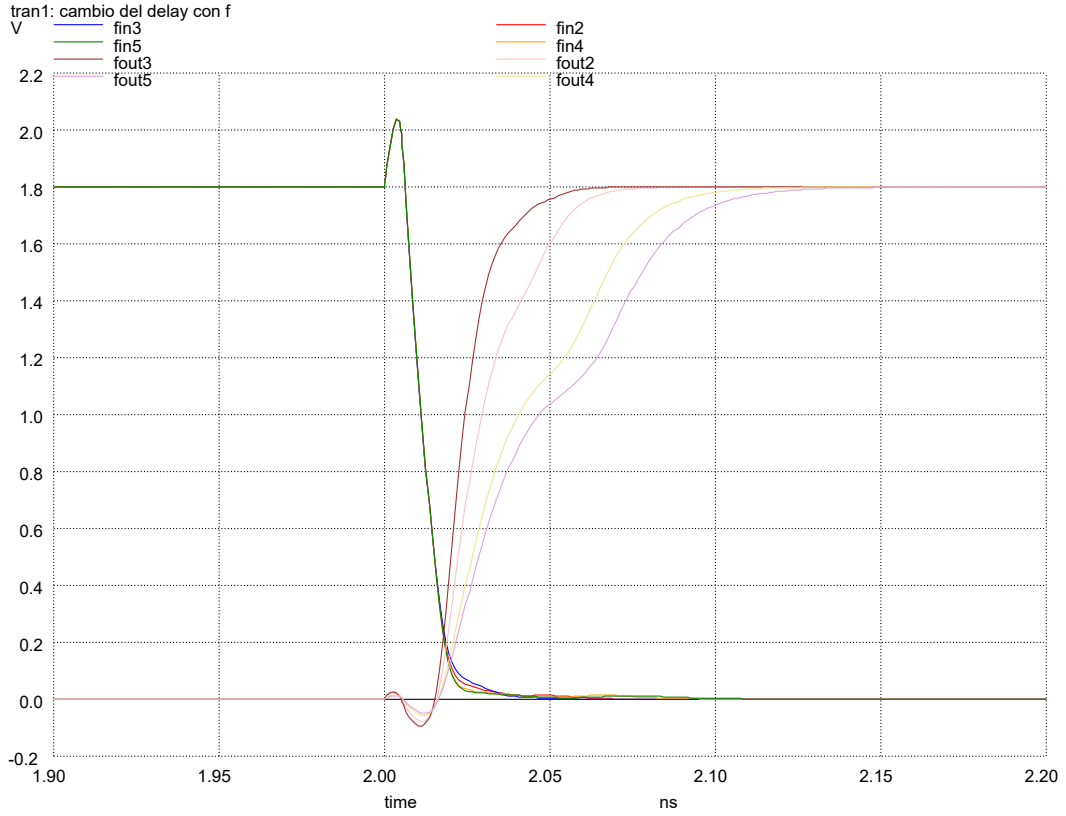
[picture p101: page 1]
time; fin3; fin2; fin5; fin4; fout3; fout2; fout5; fout4

tran1: cambio del delay con f
