gsuckz/SAR_ADC_IHP/tex/svg-inkscape/imcs_diagrama_svg-raw.pdf

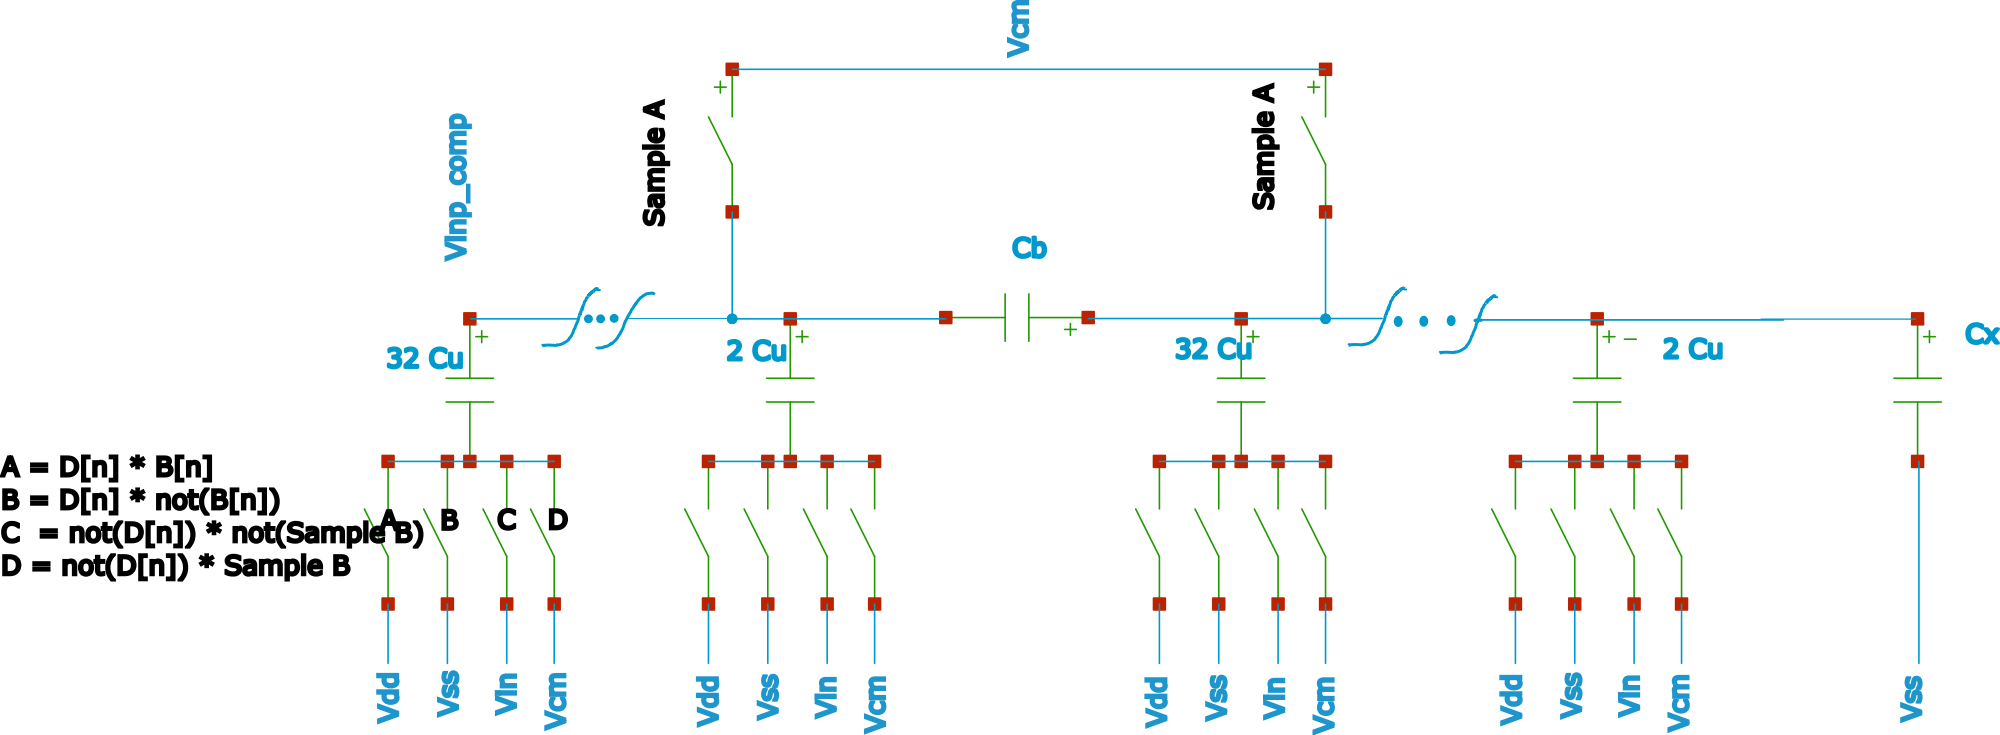
[picture p102: page 1]
