gsuckz/SAR_ADC_IHP/tex/svg-inkscape/latch_diagrama_svg-raw.pdf

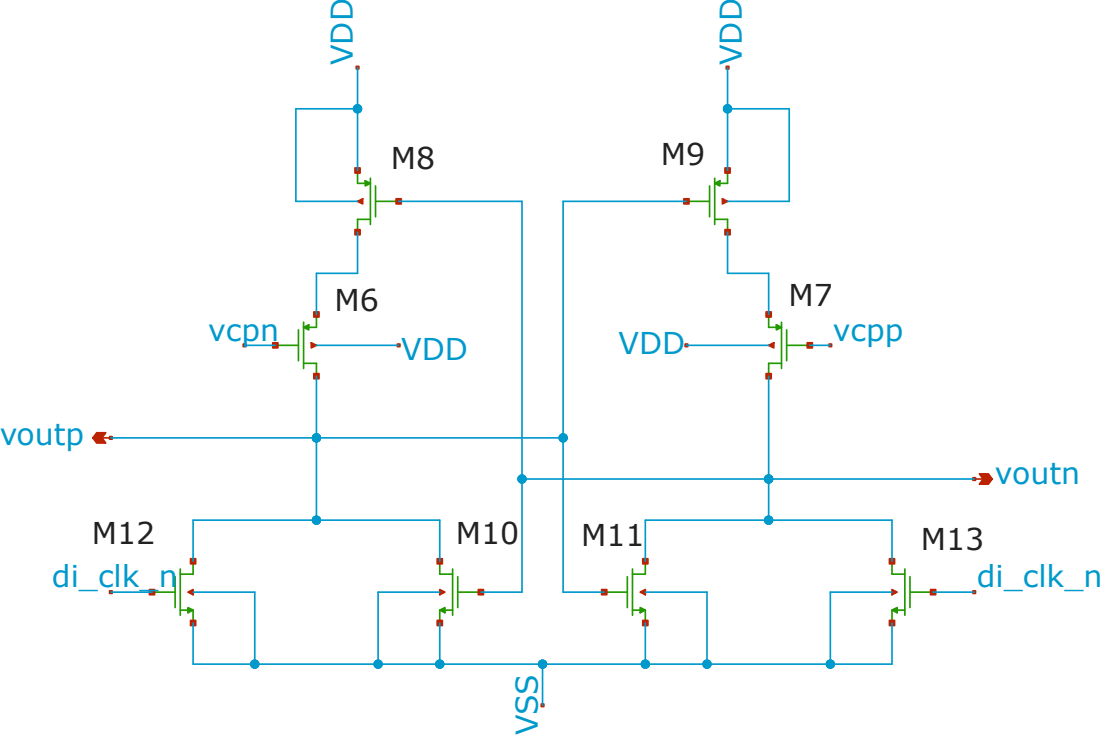
[picture p103: page 1]
voutp; voutn; M13 VSS; VDD; di_clk_n; vcpn; vcpp
