gsuckz/SAR_ADC_IHP/tex/svg-inkscape/pgen_diagrama_svg-raw.pdf

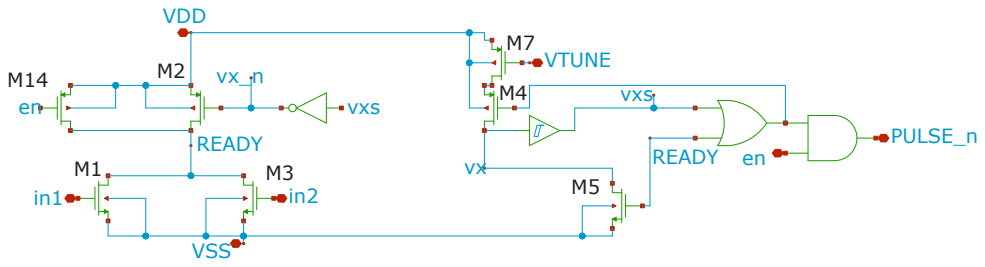
[picture p104: page 1]
VDD; VSS; READY; VTUNE; PULSE_n; vxs
