gsuckz/SAR_ADC_IHP/tex/svg-inkscape/retardo_buffer_comp_svg-raw.pdf

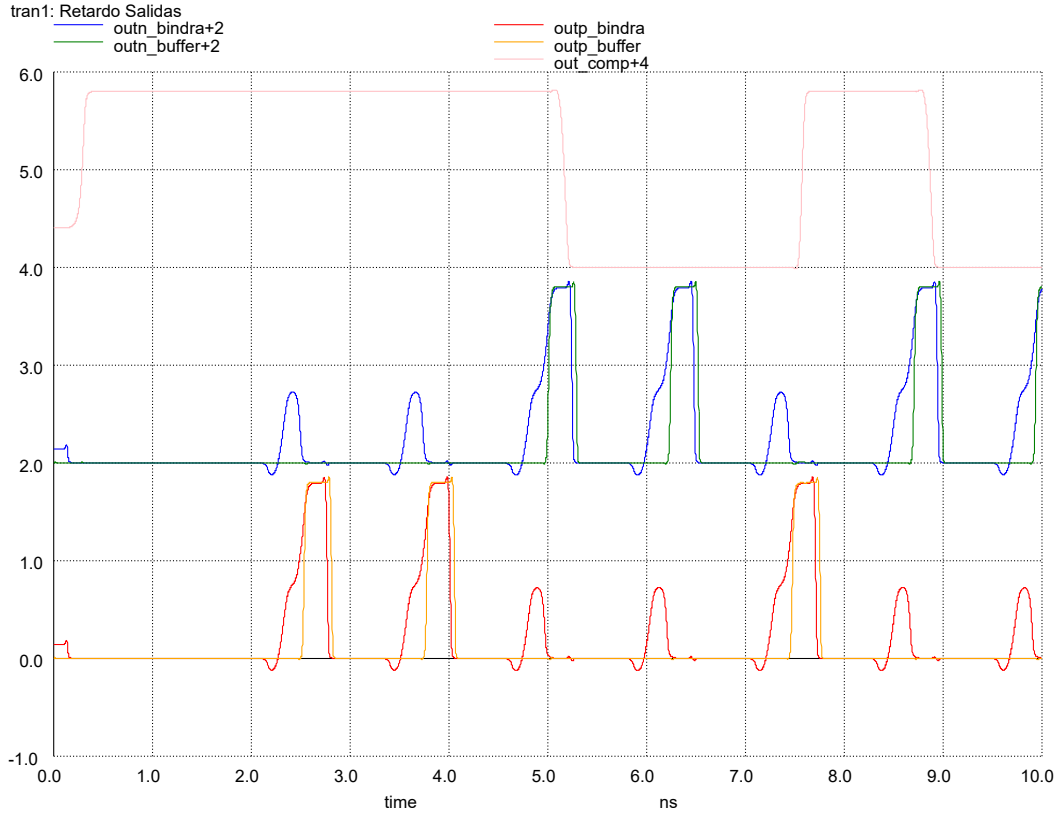
[picture p105: page 1]
time; tran1: Retardo Salidas; outn_bindra+2; outp_bindra; outn_buffer+2; outp_buffer; out_comp+4
