gsuckz/SAR_ADC_IHP/tex/svg-inkscape/rise_top_svg-raw.pdf

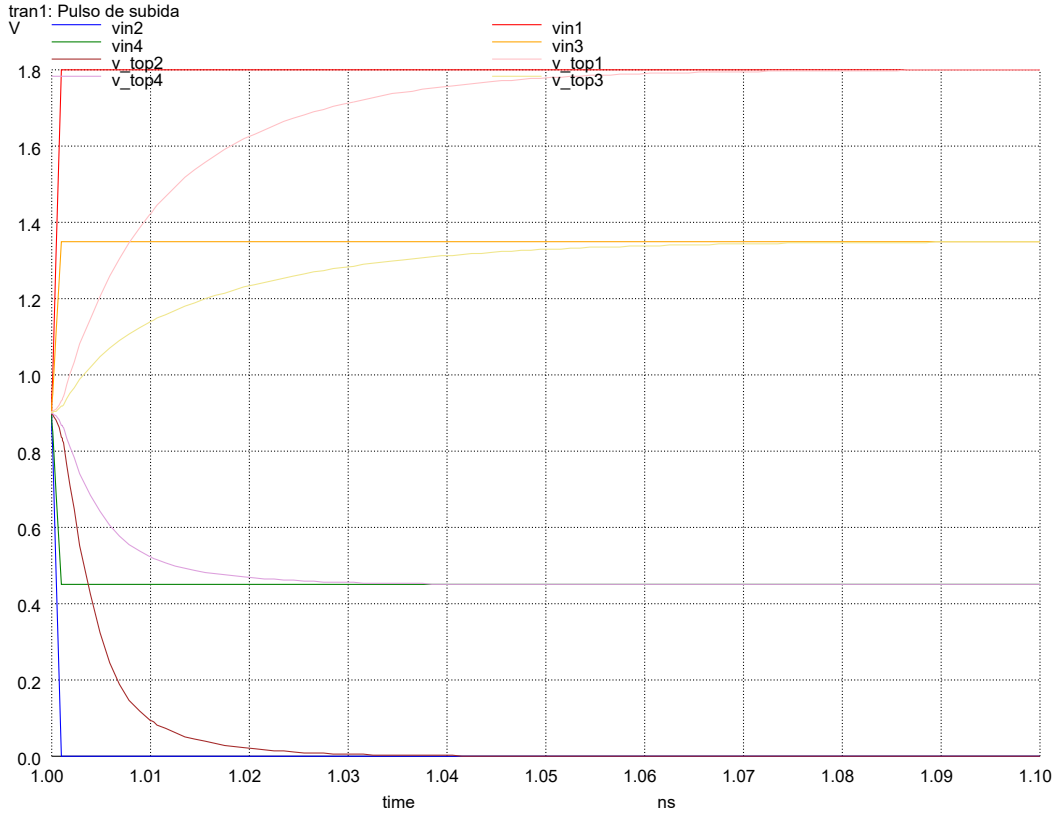
[picture p106: page 1]
time; vin2; vin1; vin4; vin3; v_top2; v_top1; v_top4; v_top3

tran1: Pulso de subida
