gsuckz/SAR_ADC_IHP/tex/svg-inkscape/salidas_comp_svg-raw.pdf

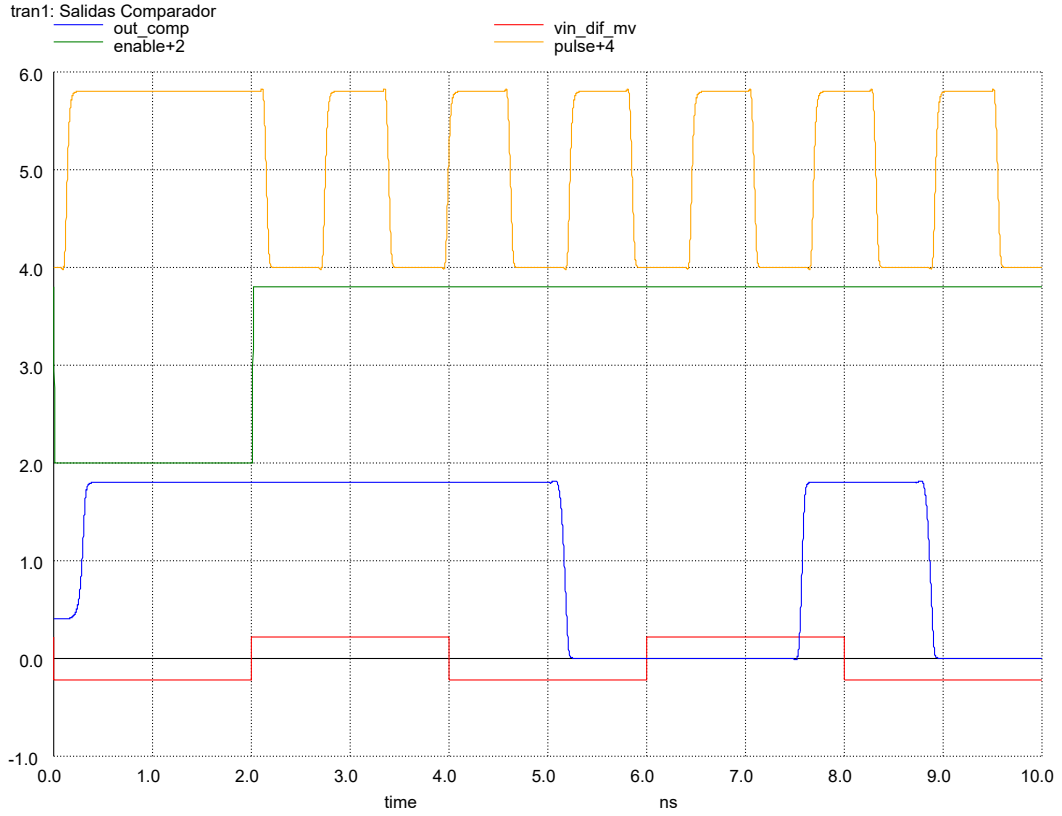
[picture p107: page 1]
time; tran1: Salidas Comparador; out_comp; vin_dif_mv; enable+2; pulse+4
