gsuckz/SAR_ADC_IHP/tex/svg-inkscape/salidas_sar_ej1_svg-raw.pdf

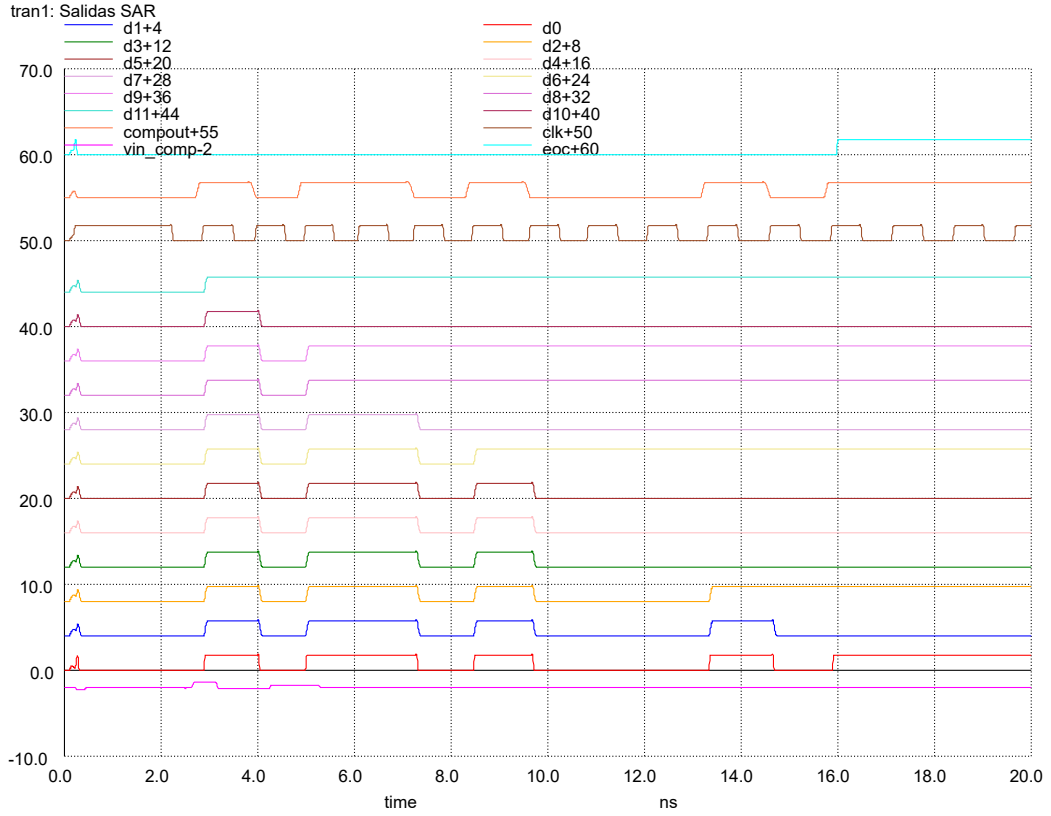
[picture p108: page 1]
time; tran1: Salidas SAR; compout+55; clk+50; vin_comp-2; eoc+60
