gsuckz/SAR_ADC_IHP/tex/svg-inkscape/senales_pgen_svg-raw.pdf

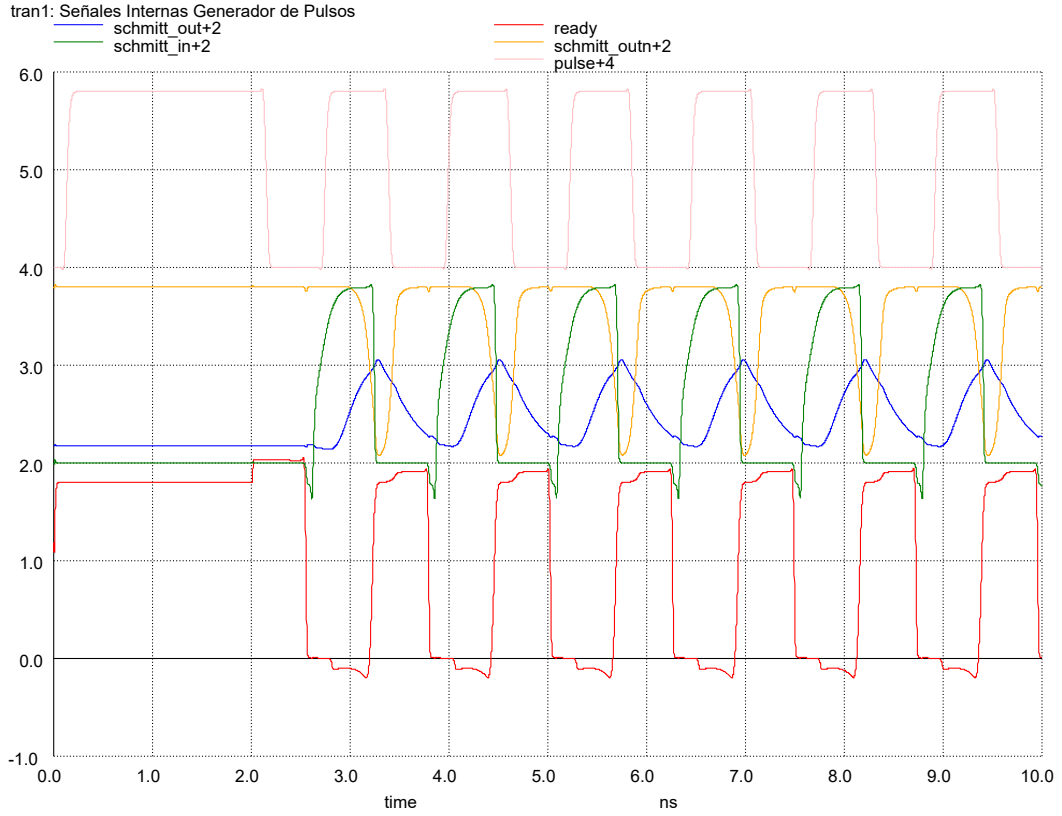
[picture p109: page 1]
time; schmitt_out+2; ready; schmitt_in+2; schmitt_outn+2; pulse+4

tran1: Señales Internas Generador de Pulsos
