gsuckz/SAR_ADC_IHP/tex/svg-inkscape/tiempo_rst_comp_editado_svg-raw.pdf

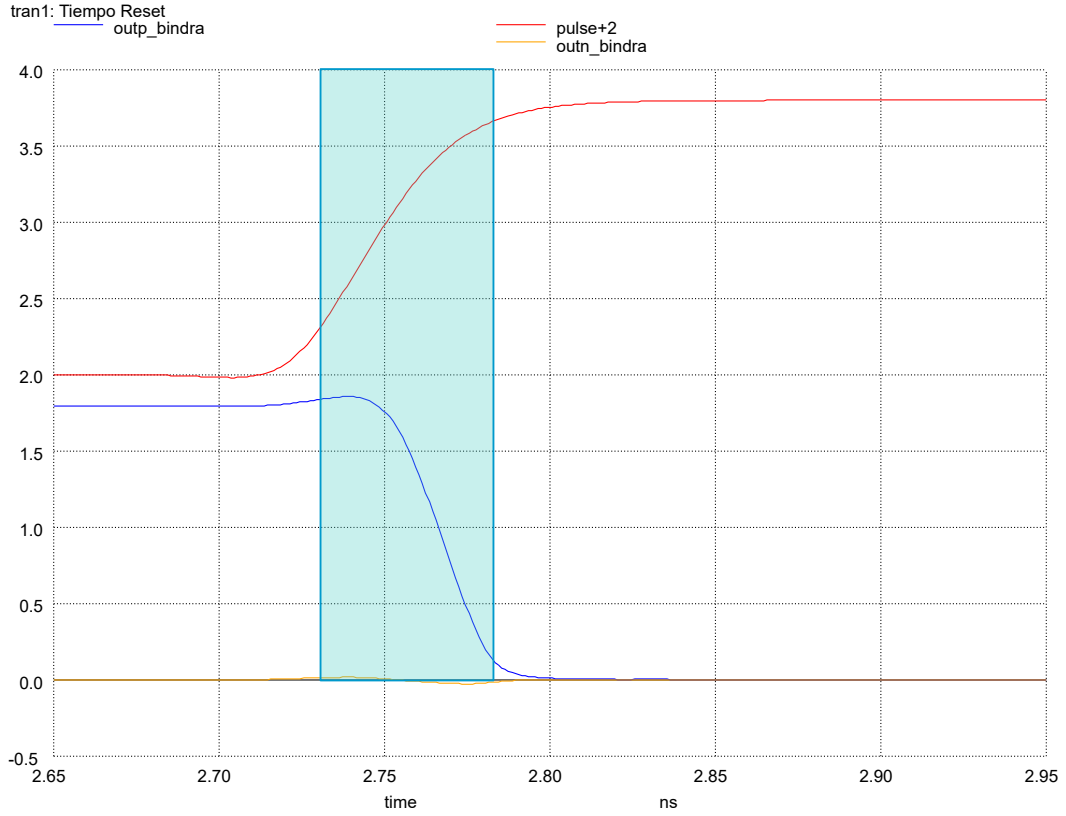
[picture p110: page 1]
time; tran1: Tiempo Reset; outp_bindra; pulse+2; outn_bindra
