gsuckz/SAR_ADC_IHP/(commit log)

2025-08-05 Primer commit
    [CT_comparator_ideal.sch, CT_comparator_ideal_tb_dc.sch, CT_comparator_ideal_tb_tran.sch, Chevella_comparator.sch, Chevella_comparator_tb_ac_cin.sch, Chevella_comparator_tb_tran.sch, Chevella_comparator_tb_tran_offset.sch, DT_comparator.sch]
2025-08-05 Elim Buffer señales sw
    [dac.sch, dac_switch.sch, dac_switch_n.sch, tb_dac.sch, tb_unit_cell_tran.sch, unit_cell.sch, unit_cell_n.sch]
2025-08-05 Corregir tb_dac
    [bit_cell.sch, dac.sch, tb_dac.sch, tb_unit_cell_logic_reg_tran.sch]
2025-09-08 Encontrado Error ctrl tgate
    [DT_comparator.sch, dac.sch, sar.sch, tb_capacitor.sch, tb_dac_only.sch, tb_sar_adc.sch]
2025-09-18 corregida cdac_cell_n
    [dac.sch, dac_switch.sch, dac_switch_n.sch, tb_capacitor_tgate_time.sch, tb_unit_cell_n_tran.sch, unit_cell_n.sch]
2025-09-19 Agregado NOL
    [tb_unit_cell_logic_reg_tran_v2.sch, transmission_gate_hv_wo_dummy.sch, transmission_gate_lv_w_dummy.sch, transmission_gate_lv_wo_dummy.sch, untitled-2.sch]
2025-09-22 Encontrado error dac
    [tb_unit_cell_logic_reg_tran_v2 - copia.sch, tb_unit_cell_logic_reg_tran_v2.sch, transmission_gate_lv_w_dummy.sch]
2025-09-23 elim. a_rail
    [dac.sch, dac_switch.sch, dac_switch_n.sch, sar.sch, tb_capacitor_tgate_time.sch, tb_unit_cell_logic_reg_tran_v2 - copia.sch, transmission_gate_lv_w_dummy.sch, unit_cell.sch]
2025-09-23 Argegado tb_bootstrap
    [tb_bootstrap.sch]
2025-09-23 cambio bs
    [tb_bootstrap.sch]
2025-09-25 agregado vss bs
    [tb_bootstrap.sch]
2025-09-26 BS funciona basico
    [bootstrap.sch]
2025-09-29 cambios bs
    [tb_bootstrap_pulse.sch, tb_bootstrap_sin.sch]
2025-10-06 Agregado sw ideal dac
    [dac.sch, dac_comp_tb_tran.sch, dac_ideal.sch, dac_ideal_tb_op.sch, dac_ideal_tb_tc.sch, dac_ideal_tb_tran.sch, dac_switch.sch, dac_switch_n.sch]
2025-10-06 correciones sw serie
    [DT_comparator_tb_tran.sch, dynamic_biasing_comparator.sch, sar.sch, tb_dac.sch, tb_sar_adc.sch, unit_cell.sch, unit_cell_n.sch]
2025-10-06 Aumentada t_espera comp
    [DT_comparator.sch, bootstrap.sch, dac.sch, dac_comp_tb_tran.sch, dac_ideal.sch, dac_ideal_tb_op.sch, dac_ideal_tb_tc.sch, dac_ideal_tb_tran.sch]
2025-10-07 Agregado Py
    [adc_signals.csv, logic.sch, tb_sar_adc.sch, tb_sar_adc_dnl_inl.sch]
2025-10-07 agregado aut
    [adc_signals.csv, dac.sch, sar.sch, tb_sar_adc_param.sch, unit_cell.sch, unit_cell_n.sch]
2025-10-13 Agregados tmeas comp y cdac
    [DT_comparator.sch, DT_comparator_tb_tran.sch, dac.sch, dynamic_biasing_comparator.sch, logic.sch, pgen.sch, sar.sch, tb_bootstrap.sch]
2025-10-13 rmovido dle ctrldever
    [adc_signals.csv, mos_temp.csv]
2025-10-13 cambios lab
    [DT_comparator.sch, DT_comparator_tb_tran.sch, dynamic_biasing_comparator.sch, pgen.sch, tb_sar_adc.sch, tb_sar_adc_rampa.sch, untitled-3.sch]
2025-10-15 corr DAC. Agr gds. Probl. LSB2
    [dac.sch, dac_switch.sch, tb_dac.sch, tb_sar_adc.sch, unit_cell.sch, unit_cell_n.sch]
2025-10-15 Cambio de dummis
    [unit_cell.sch, unit_cell_n.sch]
2025-10-16 Agretb dummy
    [tb_capacitor.sch, tb_dummy.sch]
2025-10-16 Parasito 3 compuerta prob
    [dac.sch, dac_switch.sch, dac_switch_n.sch, tb_capacitor.sch, tb_dac.sch, tb_dummy.sch, tb_sar_adc.sch, transmission_gate_lv_w_dummy.sch]
2025-10-20 Corrgido paso CDAC
    [dac.sch, dac_switch.sch, dac_switch_n.sch, tb_dac.sch, tb_full_unit_cell.sch, tb_sar_adc.sch, transmission_gate_lv_w_dummy.sch, unit_cell.sch]
2025-10-21 Agregados GroundingCAps
    [dac.sch, logic.sch, tb_dac.sch, tb_full_unit_cell.sch, tb_sar_adc.sch]
2025-10-22 corregido codigo
    [dac.sch, logic.sch, tb_capacitor.sch, tb_dac_peor_caso_lsb.sch, tb_sar_adc.sch]
2025-10-23 sar_adc.sch v 1.0
    [DT_comparator.sch, sar.sch, tb_sar_adc.sch, transmission_gate_lv_wo_dummy.sch]
2025-10-24 Cambio vcm y sim unit cell
    [dac.sch, dac_switch_n.sch, logic.sch, sar.sch, tb_dac.sch, tb_full_unit_cell.sch, tb_sar_adc.sch, unit_cell.sch]
2025-11-27 SAR ADC V1.1
    [DT_comparator.sch, DT_comparator_tb_tran.sch, bit_cell.sch, dac.sch, inverter_lv_tb_tran.sch, logic.sch, pgen.sch, tb_dac.sch]
2025-11-27 Agregada PruebaSim
    [plantillaPrueba.sch]
2025-11-27 Agregado tb_sar_adc_template
    [tb_sar_adc_dnl_inl.sch, tb_sar_adc_param.sch, tb_sar_adc_rampa.sch, tb_sar_adc_template.sch]
2025-11-27 Cambios sim
    [tb_sar_adc.sch, tb_sar_adc_template.sch]
2025-12-03 cambios informe
    [DT_comparator.sch, DT_comparator_tb_tran.sch, dynamic_biasing_comparator.sch, pgen.sch]
2025-12-05 Imagenes infrome
    [pgen.sch, tb_sar_adc.sch]
2025-12-09 Agregado tb S&H
    [tb_sar_adc.sch, tb_top_tran_step.sch, transmission_gate_lv_w_dummy.sch, unit_cell_n.sch]
2026-04-14 Mejorada preesentacion
    [unit_cell_n.sch]
